lenghia902/15W_audio_power_amplifier/docs/PBL2_report_vi.pdf

TRƯỜNG ĐẠI HỌC BÁCH KHOA – ĐẠI HỌC ĐÀ NẴNG

KHOA ĐIỆN TỬ - VIỄN THÔNG

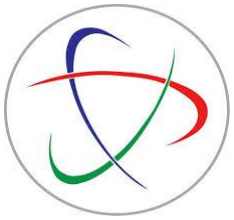
[picture p11: figure]

# PBL 2: THIẾT KẾ MẠCH ĐIỆN TỬ

## Đề tài: Mạch khuếch đại công suất OCL đơn

Giảng viên hướng dẫn:

TS. Huỳnh Thanh Tùng

Th.S Vũ Vân Thanh

Sinh viên thực hiện: Lê Khắc Nghĩa

Nguyễn Trần Tâm Nguyên

Phạm Thị Trà Giang

Đà Nẵng, ngày 28 tháng 11 năm 2025

1

MỤC LỤC

2

3

4

PHIẾU ĐÁNH GIÁ QUÁ TRÌNH THỰC HIỆN MÔN HỌC

Tên đồ án: Thiết Kế Mạch OCL Ngõ Vào Đơn

Nhóm HP: 23.Nh41A

Giảng viên hướng dẫn lý thuyết: T.S Huỳnh Thanh Tùng

Giảng viên hướng dẫn thực hành: Thầy Vũ Vân Thanh

### 1. Yêu cầu thiết kế của đề tài

-Công suất 15W | -Trở kháng loa 4Ω
-Kiểu ngõ vào đơn | -Méo phi tuyến 0,2%
-Kiểu mạch OCL | -Băng thông 50-15kHz
-Trở kháng vào Zin= 200KΩ | -Điện áp vào Vin = 0,7V

### 2. Mức độ đóng góp

STT | Họ và tên sinh viên | Mức độ đóng góp | Ghi chú
1 | Lê Khắc Nghĩa | 34%
2 | Nguyễn Trần Tâm Nguyên | 33%
3 | Phạm Thị Trà Giang | 33%

5

LỜI MỞ ĐẦU

Ngành Điện tử là một trong những ngành quan trọng góp phần vào sự phát triển của đất nước, sự phát triển nhanh chóng của Khoa học – Công nghệ làm cho ngành điện tử ngày càng phát triển và đạt được nhiều thành tựu mới

Có thể nói, mạch khuếch đại âm thanh là một trong những sản phẩm tạo nền tảng phát triển cho những sản phẩm điện tử phát triển phục vụ chon hu cầu sống của con người

Sau thời gian học tập vừa qua, với lượng kiến thức đã được tích lũy đã đảm bảo cho chúng em có thể thiết kế và thực hành được mạch khuếch đại loa. Nhờ sự hướng dẫn tận tình của thầy Huỳnh Thanh Tùng, thầy Vũ Vân Thanh cùng các anh chị đi trước chúng em đã hoàn thiện đồ án một cách tốt nhất có thể. Mặc dù vậy vẫn không thể tránh khỏi được những sai sót trong quá trình thiết kế và thi công mạch. Vì vậy nhó em rất mong nhận được những lời góp ý, giúp đỡ của thây cô để rút kinh nghiệm ở những đồ án trong tương lai

6

PHẦN 1: CƠ SỞ LÝ THUYẾT

CHƯƠNG 1: KHUẾCH ĐẠI TÍN HIỆU NHỎ

### 1.1 Khuếch đại âm tần là gì?

- Định nghĩa: Mạch khuếch đại âm tần là các mạch hoạt động với các tín hiệu hình sin và không sin, có dải tần nằm trong khoảng tai người có thể nghe được. Thông thường, tai của một người có sức khoẻ tốt có thể nghe được các âm thanh từ 20Hz đến 20KHz.
- Ta sử dụng mạch khuếch đại âm tần vì nhiệm vụ của nó là khuếch đại điện áp và công suất các dạng tín hiệu xoay chiều trong dải tần số âm thanh. Mạch khuếch đại âm tần khuếch đại các tín hiệu có tần số 20Hz đến 20KHz là dải tần số nghe được của âm thanh nên mạch khuếch đại âm tần được lựa chọn để khuếch đại các tín hiệu âm thanh.
- Mạch khuếch đại công suất âm tần dùng để tạo ra một lượng công suất để cung cấp cho tải (tải thường là loa do chúng đòi hỏi một lượng công suất lớn để biến đổi tín hiệu điện thành sóng âm). Mạch khuếch đại công suất âm tần thường được sử dụng trong các máy: radio, máy thu hình, máy nghe băng, máy tăng âm, các hệ thống stereo, loa phát thanh,…

### 1.2 Mạch phân cực

1.2.1 Mạch phân cực cố định

Sơ đồ mạch

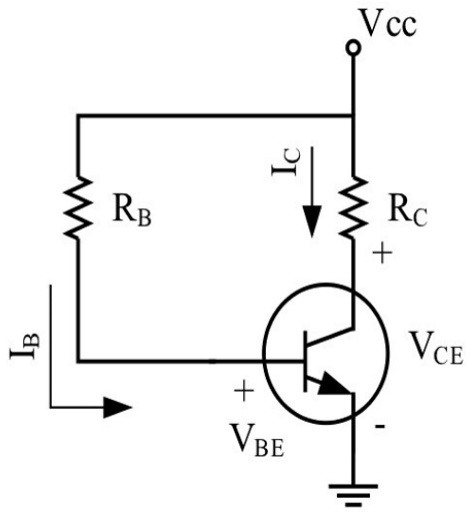
[picture p12: figure]

7

- Giả sử BJT hoạt động ở vùng tích cực (khuếch đại)
- Áp dụng KVL đối với mạch ngõ vào: VCC − IBRB − VBE = 0
- IB =

VCC−VBE
RB

Với Vbe = 0,7V nếu là loại Silic, Vbe = 0,3V nếu là loại Ge.

- Do đó, dòng IB phụ thuộc vào giá trị điện áp điện trở RB
- Trong vùng khuếch đại Ic = β.Ib
- Phương trình đường tải tĩnh Vce = Vcc – Ic.Rc
- Ưu điểm: Dòng ra lớn, dễ thiết kế.
- Nhược điểm: Khi nhiệt độ thay đổi, các đại lượng như β, Vceo, Ib thay đổi dẫn đến điểm làm việc bị sai lệch.
- Ứng dụng: Sử dụng ở các tầng công suất lớn.

1.2.2 Mạch phân cực bằng cầu phân áp

Sơ đồ mạch

- Vbb=Vcc .

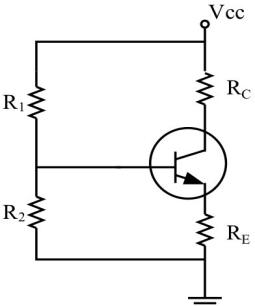
[picture p13: figure]

R2
R1+R2
- Rbb = R1//R2
- Ib=

VBB−Vbe
RBB+(β+1)RE
- Ic = β. Ib ở vùng khuếch đại
- Vce = Vcc – (Rc + Re).Ic
- Icsat =

Vcc
Rc+Re
- Ưu điểm: Việc xác định điểm làm việc tĩnh Q ít phụ thuộc vào hệ số β.
- Nhược điểm: Thiết kế và tính toán phức tạp.
- Ứng dụng: Sử dụng phổ biến trong các mạch khuếch đại, các mạch công suất lớn, BJT hoạt động ở nhiệt độ cao.

8

1.2.3 Mạch phân cực hồi tiếp Emitter

- IB =

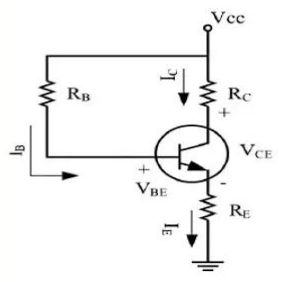
[picture p14: figure]

VCC−VBE
RB+(β+1)RE
- Trong vùng khuếch đại IC = β.IB
- Phương trình đường tải tĩnh VCE = VCC − (RC + RE) . IC
- Icsat =

VCC
RC+RE
- Ưu điểm: Có trở hồi tiếp cực E, tăng độ ổn định của điểm làm việc tĩnh.
- Nhược điểm: Việc xác định điểm làm việc vẫn còn phụ thuộc nhiều vào β.
- Ứng dụng: Sử dụng ở các tầng công suất.

1.2.4 Mạch phân cực hồi tiếp Collector

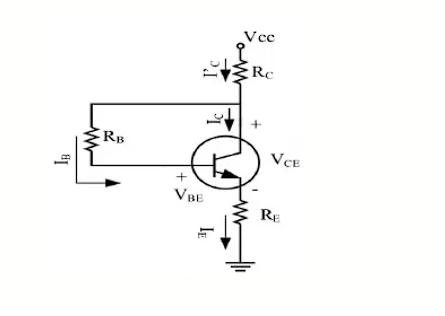
[picture p15: figure]

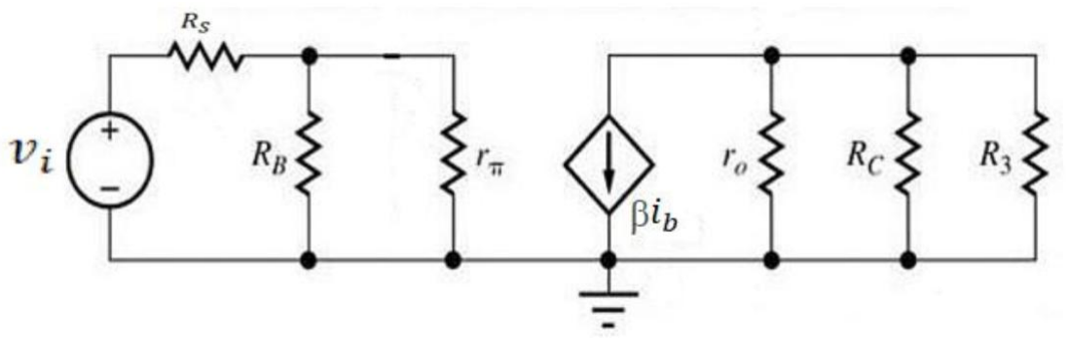
[picture p16: figure]

9

- IB =

VCC−VBE
RB+β(RC+RE)
- IC = β . IB trong vùng khuếch đại
- VCE = VCC − (RC + RE

). IC
- Ưu điểm: Khả năng hồi tiếp tốt hơn hồi tiếp cực Emitter, cải thiện độ ổn định của BJT.
- Nhược điểm: Khó thiết kế và tính toán.

### 1.3 Cách mắc BJT

1.3.1 Mạch khuếch đại mắc E chung

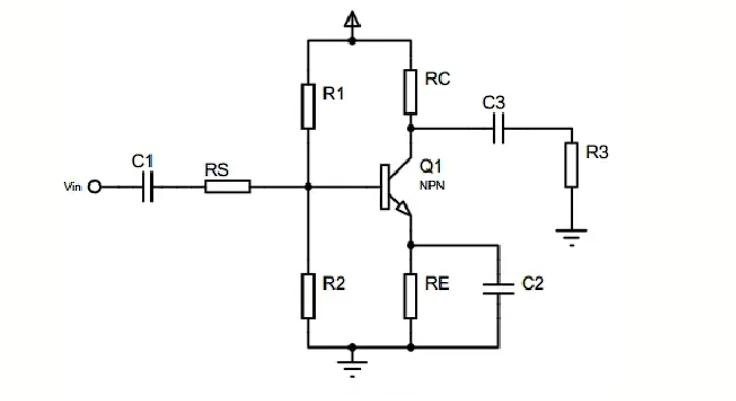
[picture p17: figure]

Sơ đồ tương đương hai chiều

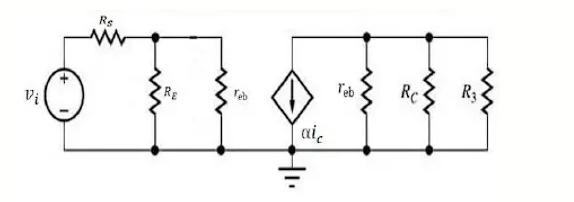
[picture p18: figure]

10

- Hệ số khuếch đại điện áp: Av = −gm. RL

Rin

RI+Rin

với Rin = R1//R2 // rπ

- Hệ số khuếch đại dòng: Ai = Av .

RI+Rin
R3
- Hệ số khuếch đại công suất: Ap = Av
. Ai
- Rout = r0 // RC
- Điều kiện của vi để mạch hoạt động tuyến tính: vi ≤ 0.005.

RI+Rin

Rin
- Tín hiệu vào và ra ngược pha nhau.
- Ưu điểm: Khuếch đại đồng thời cả áp và dòng.
- Nhược điểm: Hệ số khuếch đại ở mức trung bình.
- Ứng dụng: Sử dụng ở các tầng đầu vào và tầng thúc của mạch khuếch đại công suất

1.3.2 Mạch khuếch đại mắc B chung

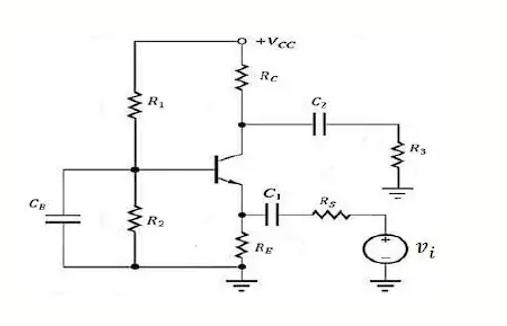
[picture p19: figure]

Sơ đồ tương đương xoay chiều

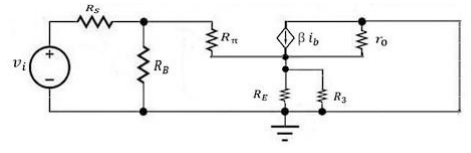
[picture p20: figure]

11

- Hệ số khuếch đại điện áp: Av =

gmRLRin
(RI+Rin)
- Rin =

1
gm

// RE

- Hệ số khuếch đại dòng: Ai = Av .

RI+Rin
R3
- Hệ số khuếch đại công suất: Ap = Av . Ai
- Rout = Ric // RC
- RiC = r0(1 + gm(RI// RE))
- Điều kiện của vi để mạch hoạt động tuyến tính: vi ≤ 0.005.

RI+Rin

Rin
- Tín hiệu vào và ra đồng pha
- Ưu điểm: Hệ số khuếch đại áp lớn, trở kháng vào mạch lớn
- Nhược điểm: Không khuếch đại dòng
- Ứng dụng: Sử dụng trong các mạch yêu cầu áp ra cao

1.3.3 Mạch khuếch đại mắc C chung

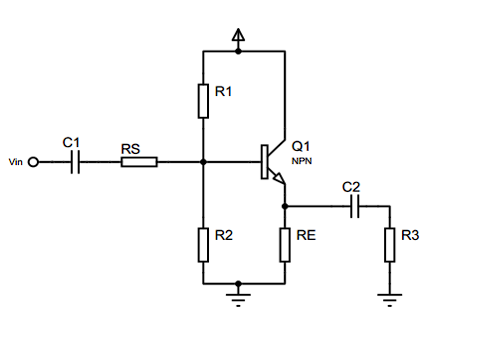
[picture p21: figure]

Sơ đồ tương đương xoay chiều

12

- Hệ số khuếch đại điện áp: Av =

gmRLRin
(RI+Rin)(1+gmRL)
- Rin = rπ(1 + gmRL)//RB
- Hệ số khuếch đại dòng: Ai = Av .

RI+ Rin
R3
- Hệ số khuếch đại công suất: Ap = Av . Ai
- Rout = (

1
gm

+

RI / / RB
β+1

) // R3

- Điều kiện của vi để mạch hoạt động tuyến tính: vi ≤ 0.005.

RI+Rin

Rin

(1 +

gmRL)
- Tín hiệu vào và ra đồng pha
- Ưu điểm: Hệ số khuếch đại áp lớn, trở kháng vào mạch lớn
- Nhược điểm: Hệ số khuếch đại áp xấp xỉ bằng 1
- Ứng dụng: Sử dụng trong các tầng yêu cầu dòng ra cao, tầng công suất

### 1.4 Kết luận

- Tầng khuếch đại tín hiệu nhỏ giúp khuếch đại dòng điện và điện áp tạo tiền đề để chuyển qua tầng thúc.
- Mạch C chung khuếch đại dòng lớn, không khuếch đại điện áp, tín hiệu vào và ra đồng pha nhau.
- Mạch E chung khuếch đại cả áp và dòng, tín hiệu vào và ra ngược pha nhau.
- Mạch B chung có hệ số khuếch đại điện áp lớn, khuếch đại dòng thấp, tín hiệu vào và ra đồng pha nhau.

KẾT LUẬN CHƯƠNG

Tầng khuếch đại tín hiệu nhỏ giúp khuếch đại dòng điện và điện áp tạo tiền đề để chuyển qua tâng thúc, nhưng vì tầng khuếch đại tín hiệu nhỏ thường không ổn định do nhiệt độ thay đổi nên ta cần hồi tiếp tín hiệu ra trở về tín hiệu vào.

13

CHƯƠNG 2: MẠCH KHUẾCH ĐẠI HỒI TIẾP

### 2.1. Giới thiệu chung

Chương 2 giới thiệu những kiến thức cơ bản về mạch khuếch đại hồi tiếp, bao gồm khái niệm, nguyên lý hoạt động và vai trò của hồi tiếp trong việc ổn định và cải thiện đặc tính của bộ khuếch đại. Nội dung chương cũng trình bày mạng 4 cực hồi tiếp và phân tích ảnh hưởng của hồi tiếp âm đến các thông số quan trọng của mạch.

### 2.2. Định nghĩa khuếch đại hồi tiếp

Mạch hồi tiếp là mạch lấy một phần năng lượng ở ngõ ra đưa về cung cấp cho ngõ vào để điều chỉnh lại các thông số và chỉ tiêu kỹ thuật của mạch khuếch đại.
Sơ đồ khối khuếch đại có hồi tiếp

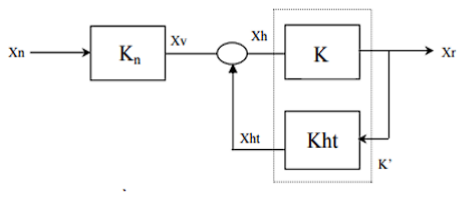
[picture p22: figure]

Hình 2.1 Khối bộ khuếch đại có hồi tiếp

K: Hệ số khuếch đại; Kℎt

: Hệ số hồi tiếp

Xv

: Tín hiệu vào; Xℎ: Tín hiệu hiệu

Xr

: Tín hiệu ra; Xℎt

: Tín hiệu hồi tiếp

- Mạch điện của bộ khuếch đại có hồi tiếp ân được phân làm 4 loại:
- Hồi tiếp nối tiếp – điện áp: Tín hiệu hồi tiếp đưa về đầu vào nối tiếp với

nguồn tín hiệu ban đầu và tỉ lệ với điện áp ở đầu ra

- Hồi tiếp song song – điện áp: Tín hiệu hồi tiếp về đầu vào song song với

nguồn tín hiệu ban đầu và tỉ lệ với điện áp đầu ra

- Hồi tiếp nối tiếp – dòng điện: Tín hiệu hồi tiếp về đầu vào nối tiếp với nguồn

tín hiệu ban đầu và tỉ lệ dòng điện ra

- Hồi tiếp song song – dòng điện: Tín hiệu hồi tiếp về đầu vào song song với

nguồn tín hiệu ban đầu và tỉ lệ với dòng điện ra

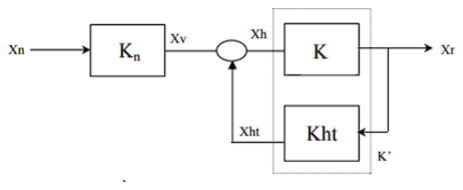
[picture p23: figure]

14

### 2.3. Hồi tiếp âm

2.3.1. Các phương trình cơ bản của mạng 4 cực hồi tiếp âm

Hình 2.2 Sơ đồ mạng 4 cực hồi tiếp

Xv
: Tín hiệu vào của toàn mạch

Kn: Hàm truyền của mạch vào

Xr
: Tín hiệu ra của mạch

K: Hàm truyền đạt của mạch khi khong có hồi tiếp

Xℎ = Xv − Xℎt = Xv − Kℎt

.Xr = Xr − Kℎt

. Xℎ.K → Xℎ =

Xv
1 + K.Kℎt

Với Kℎt

: Hàm truyền đạt của mạch hồi tiếp

-Hệ số khuếch đại khi có hồi tiếp âm

K

′ =

Xr
Xv

=

Xr
(1 + K.Kℎt)Xℎ

=

K. Xn
(1 + K.Kℎt)Xℎ

=

K
1 + K.Kℎt

Nếu không có hồi tiếp âm (Kℎt= 0) → K

′= K

Nếu có hồi tiếp âm (Kℎt ≠ 0) → K

′ < K

15

-Hệ số khuếch đại toàn mạch của mạch điện

Ktp = Kn.K

′ = Kn.

K
1 + K.Kℎt

-Hệ số khuếch đại vòng: Kv = K.Kℎt

-Độ sau hồi tiếp: g = 1 + K.Kℎt = 1 + Kv

→ K

′ =

K
g

; Ktp =

Kn.K
g

g > 1 → K

′ < K: có hồi tiếp âm

g < 1 → K

′ > K: có hồi tiếp dương

2.3.2. Ảnh hưởng của hồi tiếp âm đến các tính chất của bộ khuếch đại]
- Khi có hồi tiếp âm K

′ < K nên hệ số khuếch đại giảm

- Ảnh hưởng đến trở kháng vào

+ Sự thay đổi trở kháng vào chỉ phụ thuộc vào cách mắc mạch hồi tiếp về đầu vào

mà không phụ thuộc cách lấy tín hiệu ở đầu ra

+ Trở kháng vào của bộ khuếch đại có hồi tiếp âm nối tiếp tăng g lần so với mạch

không có hồi tiếp

-Ảnh hưởng đến độ ổn định của hệ số khuếch đại

Ktp = Kn.

K
1 + K.Kℎt

Giả sử vì một lý do nào đó, hệ số khuếch đại ∆K, lập tức theo vòng hồi tiếp âm sẽ

có 1 phần tín hiệu đưa ngược trở lại đầu vào và ngược pha tín hiệu vào, kéo hệ số

khuếch đại trở về giá trị ban đầu

Ảnh hưởng đến nhiễu và tạp âm

16

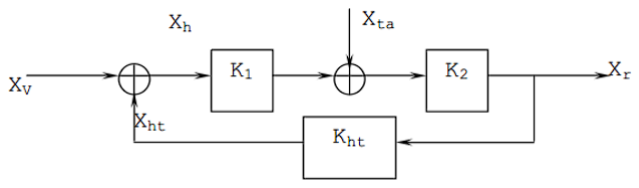
[picture p24: figure]

Hình 2.3 Ảnh hưởng của hồi tiếp âm đến nhiễu và tạp âm

Xta: Xuất hiện ở cửa ra tầng khuếch đại 1, mắc thêm K2 vào vòng hồi tiếp âm Ta có: [(Xv − Xℎt).K1 + Xta ].K2 = Xr ↔ K1K2
.Xv − K1K2

. Xℎt + K2

.Xta =

Xr

Thay Xℎt = Kℎt

. Xr

→ Xr =

K1.K2
1 + K1.K2.Kℎt

. Xv +

K2
1 + K1.K2.Kℎt

. Xta

Xr =

Xv

Kℎt

+

Xta
K1Ktℎ

Như vậy tín hiệu giảm Kℎt lần, nhiễu giảm K1.Kℎt
lần

-Ảnh hưởng của hồi tiếp âm đến dải thông của bộ khuếch đại và méo phi tuyến

+ Khi có hồi tiếp, toàn bộ tín hiệu đưa đến đầu vào của bộ khuếch đại và méo phi tuyến Xℎ = Xr

+ Khi có hồi tiếp, chỉ 1 phần tín hiệu đặt vào bộ khuếch đại

Xℎ= Xv

- Xℎt= Xv – K. KℎtXℎ

Xℎ=

Xv
g
Do đó dải thông của bộ khuếch đại được mở rộng

Ngoài ra, do tín hiệu vào của bộ khuếch đại có hồi tiếp Xℎ nhỏ hơn khi không có hồi tiếp g lần nên méo phi tuyến cũng giảm

17

KẾT LUẬN CHƯƠNG

Mạch khuếch đại hồi tiếp giúp cải thiện các tính chất của bộ khuếch đại, nâng cao chất lượng của bộ khuếch đại, kết hợp với tầng thúc để đưa tín hiệu sang tầng khuếch đại công suất để đảm bảo tín hiệu ít bị méo phi tuyến hơn và cho ra chất lượng âm thanh tốt hơn

18

CHƯƠNG 3: CÁC CHẾ ĐỘ KHUẾCH ĐẠI CÔNG SUẤT

### 3.1 Giới thiệu chung

- Khuếch đại công suất là tầng cuối của thiết bị khuếch đại. Nó có nhiệm vụ cung cấp cho ta một tín hiệu trung thực đạt công suất mong muốn và có hiệu suất hợp lý.

### 3.2 Các tham số của tầng khuếch đại công suất

- Hệ số khuếch đại công suất Kp =

Pr
Pv
- Hiệu suất ŋ =

Pr
Po

với Po là công suất cung cấp 1 chiều

### 3.3 Chế độ làm việc và điểm làm việc cho tầng khuếch đại công suất

- Tùy thuộc vào chế độ làm việc của transistor mà bộ khuếch đại công suất làm việc ở chế độ A, B, AB
- Khuếch đại công suất loại A: Tín hiệu được khuếch đại gần như tuyến tính, nghĩa là tín hiệu ngõ ra thay đổi tuyến tính trong toàn bộ chu kỳ 360° của tín hiệu ngõ vào (Transistor hoạt động cả hai bán kỳ của tín hiệu ngõ vào)
- Khuếch đại công suất loại AB: Transistor được phân cực ở gần vùng ngưng. Tín hiệu ngõ ra thay đổi hơn một nửa chu kỳ của tín hiệu vào (Transistor hoạt động hơn một nửa chu kỳ - dương hoặc âm – của tín hiệu ngõ vào)
- Khuếch đại công suất loại B: Transistor được phân cực tại Vbe = 0 (vùng ngưng). Chỉ một nửa chu kỳ âm hoặc dương – của tín hiệu ngõ vào được khuếch đại

19

3.3.1 Chế độ A

Đặc tuyến

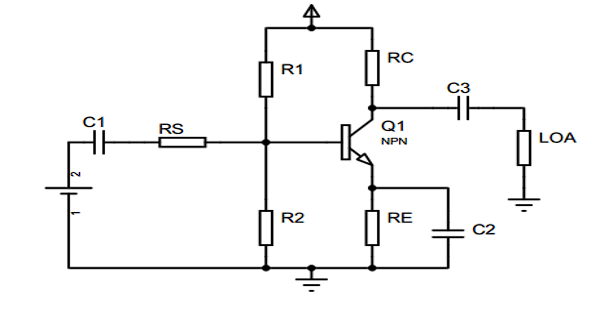
[picture p25: figure]
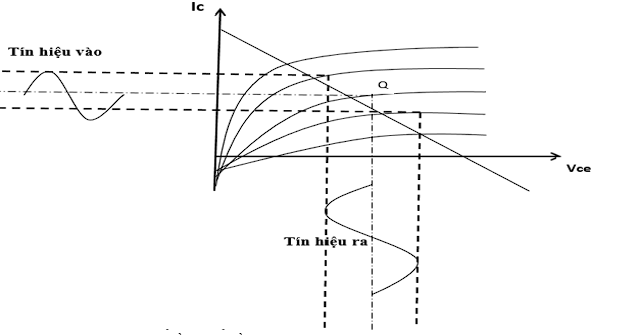
[picture p26: figure]

- Dòng điện và điện áp đầu vào tồn tại 360° trong 1 chu kỳ của tín hiệu vào
- Hiệu suất ŋ =

PL

PCC

=

VDD

ILP
2
2VDDILP

=

1
4

= 25%

- Ưu điểm: Tín hiệu ra không bị méo dạng
- Nhược điểm:
- Hiệu suất thấp ~ 25%
- Tiêu hao (nhiệt) lớn
- Ứng dụng: Sử dụng ở các tầng không yêu cầu hiệu suất cao nhưng phải đảm bảo tín hiệu như tầng đầu vào và tầng thúc của mạch khuếch đại

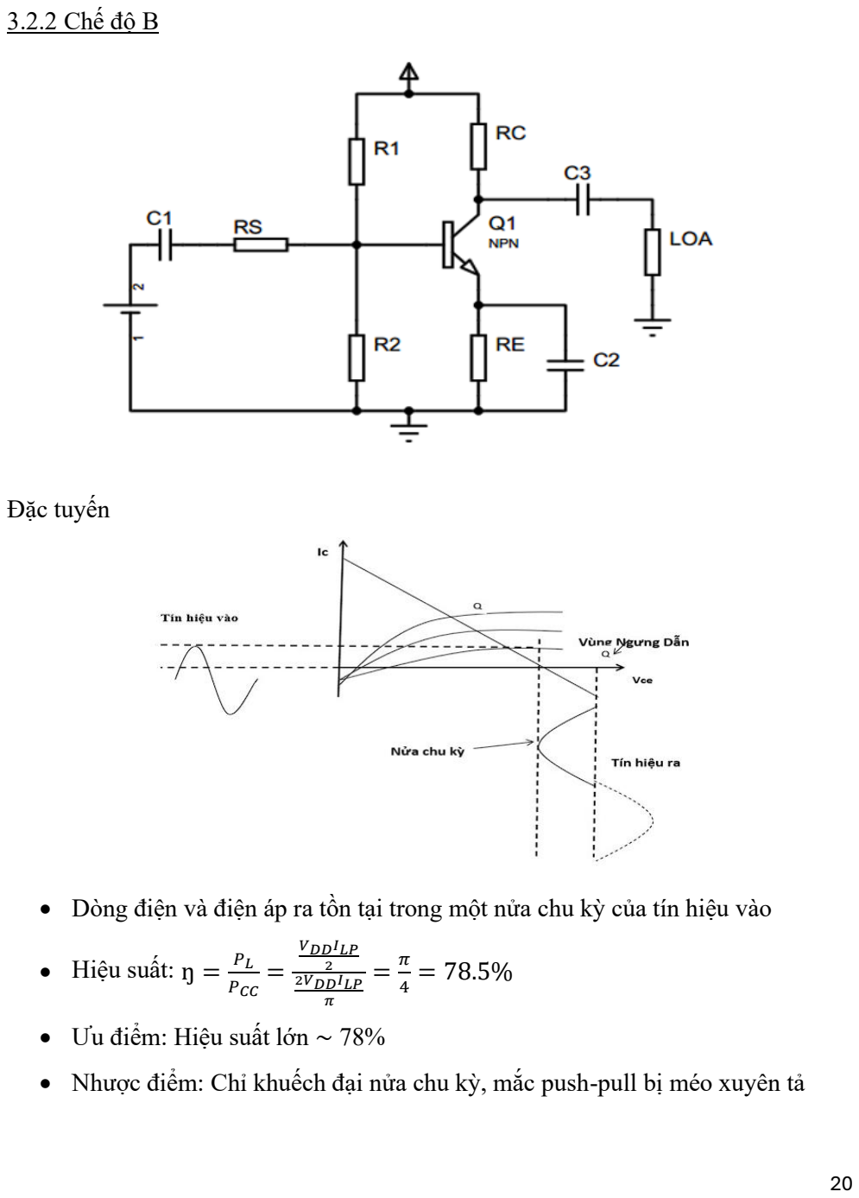
[picture p27: page 21]

20

3.2.2 Chế độ B

Đặc tuyến

- Dòng điện và điện áp ra tồn tại trong một nửa chu kỳ của tín hiệu vào
- Hiệu suất: ŋ =

PL

PCC

=

VDDILP
2
2VDDILP
π

=

π
4

= 78.5%

- Ưu điểm: Hiệu suất lớn ~ 78%
- Nhược điểm: Chỉ khuếch đại nửa chu kỳ, mắc push-pull bị méo xuyên tả

21

3.3.3 Chế độ AB

Ta có thể sửa lại vấn đề méo trong mạch loại B nhưng vẫn cải thiện hiệu suất bằng cách kết hợp 2 loại A và B

Đặc tuyến

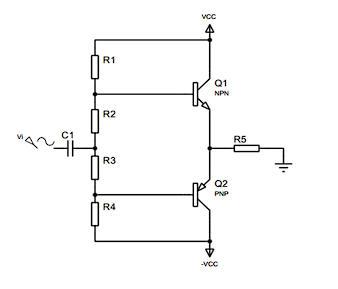
[picture p28: figure]
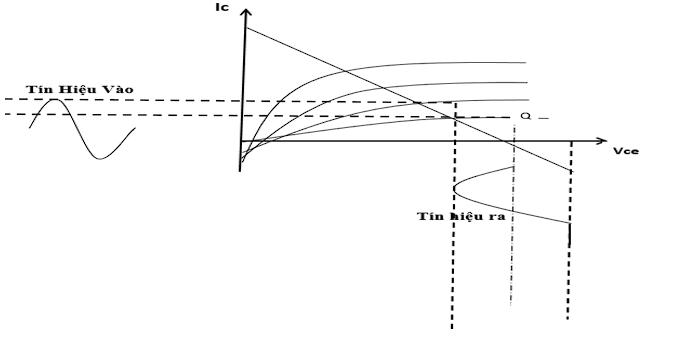
[picture p29: figure]

- Ưu điểm: Hiệu suất cao, bảo toàn tín hiệu
- Nhược điểm: Các tầng khuếch đại công suất được thiết kế làm việc ở chế độ AB, điểm làm việc của chế độ AB nằm giữa chế độ A và chế độ B

22

### 3.4 Mạch khuếch đại công suất OCL

3.4.1 Giới thiệu mạch OCL

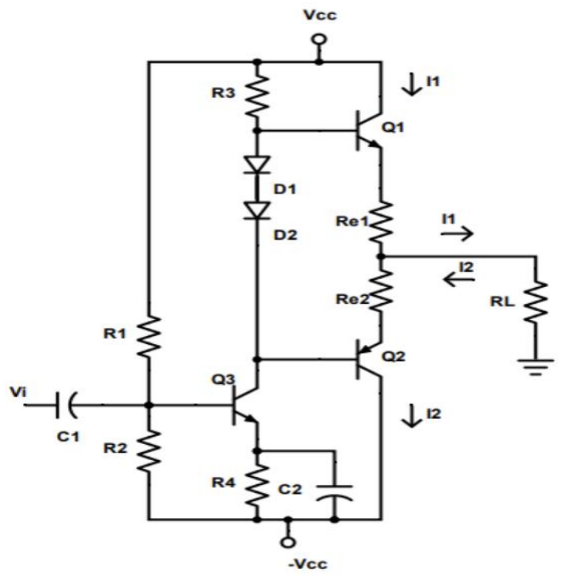
[picture p30: figure]

- Sử dụng 2 nguồn đối xứng (+/- VCC)
- Ở bán kì dương của Vi: Vb/Q3 tăng → Q3 dẫn → Vce/Q3 giảm → Vc/Q3 giảm

→ Q1 tắt, Q2 dẫn → Tín hiệu I2 chạy từ Mass → RL → Re2 → Q2 → - VCC

- Ở bán kì âm của Vi: Vb/Q3 giảm → Q3 tắt → Vce/Q3 tăng → Vc/Q3 tăng

→ Q1 dẫn, Q2 tắt → Tín hiệu I1 chạy từ VCC → Q1 → Re1 → RL → Mass

3.4.2 Ưu điểm và nhược điểm của mạch

- Ưu điểm:
- Mạch không có tụ ở đầu ra nên bang thông của mạch được mở rộng, không gây méo ở tần số thấp
- Hiệu suất cao
- Tín hiệu không bị méo xuyên tâm
- Nhược điểm:
- Mạch khó thiết kế, sử dụng nguồn đôi
- Không có tụ đầu ra, tín hiệu DC dễ đi qua loa, gây cháy loa
- Do tải ghép trực tiếp nên phải có mạch bảo vệ quá công suất

23

### 3.5 Mạch khuếch đại công suất OTL

3.5.1. Giới thiệu mạch OTL

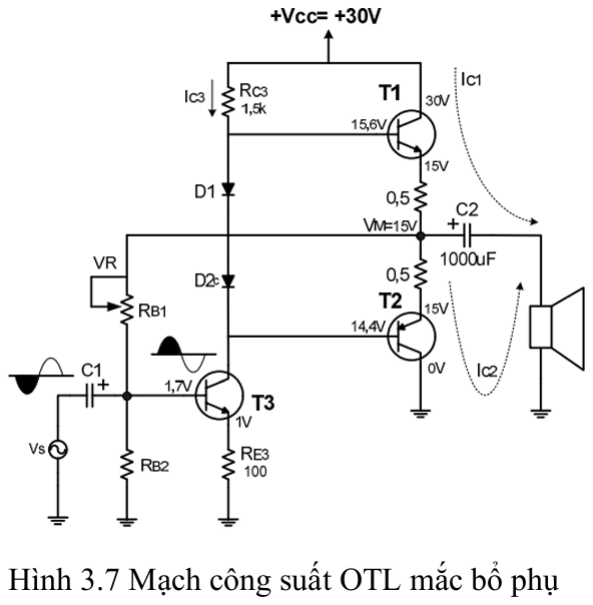
[picture p31: figure]

Mạch OTL (Output Transfomer Less) là mạch khuếch đại công suất không cần sử dụng biến áp đầu ra, được sử dụng trong các bộ khuếch đại âm thanh chất lượng cao.

Nhận xét mạch OTL:
- T1, T2 là 2 transistors có cùng thông số như công suất, hệ số khuếch đại β, được chế tạo cùng chất (thường là Si)
- T1 và T2 có cùng các thông số kỹ thuật nên trong mạch điện phải có cùng điều kiện làm việc, điện áp điểm giữa VM = 1/2 VCC
- Hai diode D1, D2 dùng để phân cực điện áp cho cực BT1 – BT2
- Mạch OTL mắc bổ phụ thường sử dụng hai BJT: một NPN và một PNP, để khuếch đại tín hiệu theo push-pull

Đặc điểm chung mạch OTL

- Sử dụng nguồn đơn, có tụ xuất âm nối với tải RL ở ngõ ra
- Tụ xuất âm ngăn dòng 1 chiều nhỏ cho thành phần xoay chiều đi qua, bảo vệ loa
- Mạch mắc kiểu bổ phụ, các transistor luân phiên dẫn mỗi con một bán kỳ của tín hiệu ngõ vào nên cho ra tải đủ cả hai bán kỳ

24

3.5.2 Ưu điểm và nhược điểm của mạch OTL

- Ưu điểm:
- Giảm độ phức tạp thiết kế, tín hiệu ra ít méo và có hiệu suất cao.
- Đáp ứng nhanh, chất lượng âm thanh cao.
- Nhược điểm:
- Thường phù hợp loa có tổng trở thấp
- Khó cân chỉnh điểm giữa, có tụ xuất âm nên gây tổn hao tín hiệu ở tần số thấp

KẾT LUẬN CHƯƠNG

Ta đã tổng hợp được kiến thức về cấu tạo nguyên lý hoạt động của các linh kiện các loại mạch khuếch đại công suất. Các định lý và công thức quan trọng đã tìm hiểu sẽ tạo cơ sở để tiến tới các bước tính toán trong chương tiếp theo

25

CHƯƠNG 4: CÁC MẠCH PHỤ TRỢ

### 4.1 Giới thiệu chung

Trong thực tế, để nâng cao hiệu suất cũng như chất lượng của mạch khuếch đại công suất, cần dung thêm các mạch bổ trợ

### 4.2 Mạch khuếch đại Darlington

Trong trường hợp các mạch khuếch đại yêu cầu có hệ số khuếch đại dòng điện lớn hay tăng trở kháng vào có thể tổ hợp một số transistor thành sơ đồ Darlington để đạt được yêu cầu trên

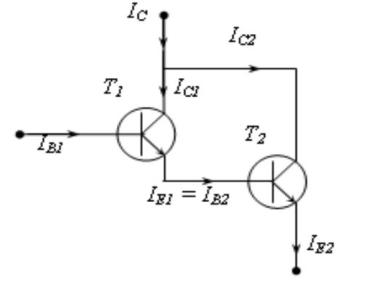
[picture p32: figure]

- Ta có: IE1 = IE2
- Ở chế độ tĩnh: IE1 = (1+ β1) IB1

→ IE2 = (1+ β2) IB2 = (1+ β2) IE1 = (1+ β2) (1+ β1) IB1

→ IE2 = β1β2 IB1 = βIB1

Vậy hệ số khuếch đại dòng của mạch: β = β1β2

26

### 4.3 Nguồn dòng

Một biện pháp phổ biến đển ổn định dòng cấp cho tầng công suất là sử dụng nguồn dòng. Ngoài ra, nguồn dòng có nội trở lớn sẽ nâng cao trở kháng ra cho tầng thúc

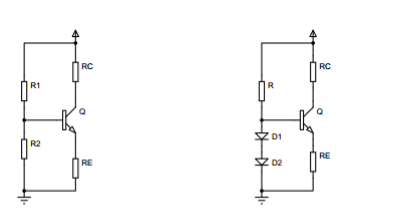
[picture p33: figure]

Hình a | Hình b
Nguồn dòng được phân cực bằng

Hình a: Điện trở; Hình b: Diode

- Việc phân cực nguồn dòng bằng điện trở có nhược điểm là không ổn định, điện áp hai đầu có thể thay đổi, nguồn cấp biến áp không ổn định → nguồn dòng không ổn định
- Để khắc phục nhược điểm trên thì phân cực bằng diode là tốt hơn, lợi dụng tính chất của sự sụt áp trên diode → tạo ra một nguồn phân cực khá ổn định

### 4.4 Mạch bù trở kháng Zobell

Mạch Zobell là mạch bù trở kháng loa ở tần số cao. Do loa có tính cảm (L) nên trở kháng loa tăng theo tần số, làm tín hiệu ra loa không ổn định, để khắc phục người ta mắc Zobell.

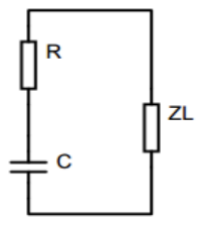
[picture p34: figure]

27

Khi tần số tăng thì ZL tăng, khi đó zC = jωC sẽ giảm, do đó Ztđ = ZL // ZC sẽ không đổi

Trở kháng loa được xác định

Ztđ = (R +

1
jωC) // (r+ jωL) =

(R +

1
jωC).(r+ jωL)

R +

1

jωC + r + jωL =

r.(1−ω²RLC
r

)+jω.(RC+

L
r

)
1 − ω²LC + jωC.(R+r)

KẾT LUẬN CHƯƠNG

Mạch khuếch đại Darling, nguồn dòng và mạch bù trở kháng Zobel đều đóng vai trò quan trọng trong việc ổn định và nâng cao các thông số của mạch.

28

PHẦN 2: THIẾT KẾ VÀ TÍNH TOÁN

Yêu cầu:

- Công suất: 15W
- Loại mạch: OCL đơn
- Trở kháng vào: 200000 Ohm
- Trở kháng loa: 4 Ohm
- Băng thông: 50 – 15000 Hz
- Méo phi tuyển 0.2%

Sơ đồ thiết kế


29

CHƯƠNG 5: TÍNH TOÁN PHẦN NGUỒN

Giả sử tín hiệu vào có dạng:

vi = VIP. sin ωt

Tín hiệu ra loa có dạng:

vL = VL

. sin ωt (V)

iL = IL

. sin ωt (A)

Với VL
là điện áp cực đại trên tải

IL
là dòng điện cực đại qua tải

Điện áp hiệu dụng và dòng hiệu dụng qua tải

Ta có: VLℎd =

VL
√2

và ILℎd =

IL
√2
Công suất trên tải:

PL = RL

.ILℎd

2 =

VLℎd

2
RL

=

VLP

2
2RL

→ VL = √2PLRL = √2.15.4 = 10,954 (V)

→ IL =

VL
RL

= 2,74 (A)

Điện áp nguồn cung cấp:

Ta có Q1,Q2 làm việc ở chế độ AB nên chọn hệ số sử dụng nguồn là ε = 0,8

→ Vcc =

VL
0,8

= 13,75 (V)

→ Ta chọn nguồn cung cấp là ±18V

30

Dòng cung cấp trung bình:

ICCtb =

2IL
π
→ Pcc = ICCtb. Vcc = 31,4 (W)

PL =

1
2

. RL

.IL

2 = 15 (W)

Hiệu suất mạch:

ŋ =

PL

Pcc

. 100% =

15
31,4

. 100% = 47,77 %

31

CHƯƠNG 6: TÍNH TOÁN TẦNG CÔNG SUẤT

### 6.1 Tính chọn trở R1, R2

Vì mạch làm việc ở chế độ AB nên dòng tĩnh collector nằm trong khoảng 20 ÷ 50mA. Ở đây ta chọn: IE/Q1 = IE/Q2 = 50 (mA)

Dòng cực đại qua Q1, Q2 là:
IE/Q1 = IE/Q2 = IE/Q1 + IL = 0,05 + 2,74 = 2,79 (A)

R1, R2 là hai điện trở ổn định nhiệt, tạo dòng hồi tiếp để cân bằng tầng đẩy kéo, dòng qua tải cũng chính là dòng qua trở, để không ảnh hưởng đến công suất của tải nên phải có công suất lớn.

Để công suất ra loa đạt cực đại thì sụt áp trên 2 điện trở này không quá lớn, tránh hao phí ta chọn:

VR1
VL

≥

1
20 → VR1 ≥

VL
20

=

10,954
20

= 0,55 (V)

→ R1 = R2 =

VR1

IE/Q1

= 0,197 (Ω)

Công suất trở R1, R2:

PR1 = PR2 =

1
2

R1.IL

2 = 0,37 (W)

→ Ta chọn trở R1, R2 là 0, 22Ω/2W

### 6.2 Tính chọn cặp Q1, Q2

Công suất nguồn cung cấp:

PCC = VCC.ICCtb = VCC.

2IL
π

Công suất loa: PL = RL

.ILℎd

2 =

1
2

RL

IL

2

32

Công suất tiêu tán của R1, R2:

PR = 2PR1 =

1
2

RL

IL

2

Vậy công suất tiêu tán của 2 BJT Q1, Q2:

2Ptt = PCC − PL − 2PR =

2VCCIL
π

−

1
2

RL

IL

2 − 2.

1
2

R1IL

2

Công suất tiêu tán của 1 BJT là:

Ptt/Q1 = Ptt/Q2 =

VCCIL
π

−

1
4

(RL + 2R1).IL

2
(1)

Công suất tiêu tán cực đại của BJT là lấy đạo hàm theo IL cho bằng 0:

dPtt/Q1
dIL

=

VCC
π

−

1
2

(RL + 2R1).IL = 0

→ IL =

2VCC
π(RL+2R1)

(2)

Thay (2) vào (1), ta được:

Pttmax/Q1 =

2VCC

2
π

2(RL + 2R1)

−

1
4

4VCC

2
π

2(RL + 2R1)
2

. (RL + 2R1) = 7,78 (W)

Công suất tiêu tán tĩnh trên Q1:

PttDC/Q1 = VCE/Q1.IC/Q1 ≈ VCC.IEQ = 0,9 (W)

Vậy công suất tiêu tán cực đại trên Q1 là:

Ptt∑ max/QB1 = Pttmax/Q1 + PttDC/Q1 = 7,78 + 0,9 = 8,68 (W)

Vì Q1, Q2 là cặp BJT bổ phụ nên ta chọn Q1, Q2 thỏa mãn điều kiện:

- IC ≥ (1,5 ÷ 2)IE/Q1 = (4,2 ÷ 5,58) (A)
- VCE0 ≥ (1,5 ÷ 2)VCC = (27 ÷ 36) (V)
- PC ≫ (1,5 ÷ 2)Ptt ∑ max = (13,02 ÷ 17,36) (W)

33

→ Tra cứu Datasheet ta chọn Q1 là và Q2 là: 2SD718 và 2SB688
Loại BJT | VCE0(V) | PC(W) | IC(A) | hfe | f (MHz) | Loại
2SD718 | 120 | 80 | 8 | 55:160 | 12 | NPN
2SB688 | 120 | 80 | 8 | 55:160 | 12 | PNP

### 6.3 Tính chọn R3, R4

Ta chọn:
βQ1 = βQ2 = 55

Dòng Base tĩnh của Q1:

IBQ/Q1 =

IEQ/Q1
1 + βQ1

=

0,05
1 + 55 = 0,89 (mA)

Dòng Base cực đại của Q1:

IBP/Q1 =

IEp/Q1
1 + βQ1

=

2,79
1 + 55 = 50 (mA)

Để R3, R4 không ảnh hưởng đến dòng ra ở chế độ xoay chiều thì R3, R4 phải thỏa mãn điều

kiện: Zac/Q1 ≪ R3, R4 ≪ Zdc.Q1

- R3,R4 ≪ Zdc.Q1để rẽ dòng nhiệt
- R3,R4 ≪ Zac.Q1 để giảm tổn thất tín hiệu

Với Zdc.Q1, Zac/Q1là điện trở xoay chiều và một chiều từ cực Base Q1

Từ đặc tuyến của IC, VBE của, ta có:

IEQ/Q1 = 0,05(A) → VBEQ = 0,6 (V)

IEP/Q = 2,79 (A) → VBEmax = 0,83 (V)

Vậy

Zdc/Q1 =

VBQ/Q1

IBQ/Q1

=

VBEQ/Q1 + VR1

IBQ/Q1

= 686 (Ω)

34

Zac/Q1 =

(VBEmax/Q1 + VR1max ) − (VBEQ/Q1 + VR1)

IBQ/Q1 − IBQ/Q1

= 16,96 (Ω)

Vậy: 16,96 Ω ≪ R3, R4 ≪ 686 Ω

→ Chọn R3, R4 = 220Ω/2W

### 6.4 Tính chọn cặp Q3 Q4

Dòng tĩnh qua R3 IR3Q =

VBEQ/Q1+ VR1
R3

=

0,6+0,05.0,22
220

= 2,78 (mA)

Dòng cực đại qua R3 IR3 =

VBE/Q1+ VR1max
R3

=

0,83+2,79.0,22
220

= 6,48 (mA)

Dòng emitter tĩnh qua Q3 IEQ/Q3 = IR3Q + IBQ/Q1 = 2,78 + 0,89 = 3,67 (mA)

Dòng cực đại qua Q3 IE/Q3 = IR3 + IB/Q1 = 50 + 6,56 = 56,56 (mA)

Khi đó trở kháng xoay chiều từ cực B của Q1

Zac/Q1

′ =

VBEmax − VBQ/Q1

IE/Q3 − IEQ/Q3

=

0,83 + 0,22.2,79 − 0,6 + 0,05.0,22
(56,56 − 3,67).0,001 | = 15,75 (Ω)

So sánh với Zac/Q1 tính ở trước là ta thấy khi thêm R3, R4 vào thì sai khác không đáng kể

Như vậy, trở kháng xoay chiều Q3 là

Zac/Q3 = Zac/Q1

′ + (1 + βmin). RL = 15,75 + (1 + 55).4 = 239,75 (Ω)

Để tìm được Q3, Q4 ta tìm công suất tiêu tán lớn nhất của chúng. Gọi là biên độ dòng AC chạy qua Q3, ta có

Dòng cung cấp xoay chiều trung bình cho Q3

Itb/Q3 =

IE1
π

Công suất nguồn cung cấp cho Q3

PCC/Q3 = 2VCC.Itb/Q3 =

2VCC.IE1
π

35

Công suất cung cấp cho tải của Q3

Pt/Q3 = Zac/Q3.IE1

2 = Zac/Q3

1
2π

∫ (IE1. sinωt)
2
dωt =

π

0

1
4

IE1

2
. Zac/Q3

Công suất tiêu tán xoay chiều trên Q3

Ptt/Q3 = PCC/Q3 − Pt/Q3 =

2VCCIE1
π

−

1
4

IE1

2 Zac/Q3

Lấy đạo hàm theo và cho ta được:

IE1 =

4VCC

π. Zt/Q3

=

4.18
π. 239,75 = 0,096 (A)

Vậy công suất tiêu tán lớn nhất do dòng xoay chiều rơi trên Q3

Pttmaxac/Q1 =

2VCC.IE10
π

−

1
4

IE1

2
. Zac/Q3 = 0,548 (W)

Công suất tiêu tán tĩnh trên Q3

Pdc/Q3 = VCC.IEQ/Q3 = 18.3,67.0,001 = 0,066 (W)

Vậy tổng công suất tiêu tán cực đại trên Q3

∑Pttmax/Q3 = Pdc/Q3 + Pttmaxac/Q3 = 0,066 + 0,548 = 0,614 (W)

Vậy chọn Q3, Q4 là cặp bổ phụ thỏa mãn điều kiện sau

- IC ≥ (1,5 ÷ 2)IC/Q3 = (84,8 ÷ 113,12) (mA)
- VCE0 ≥ (1,5 ÷ 2)VCC = (27 ÷ 36) (V)
- PC ≥ (1,5 ÷ 2) ∑ Pttmax/Q3 = (0,92 ÷ 1,23) (W)

Tra cứu Datasheet ta chọn Q3 là và Q4 là TIP41C và TIP42C
Loại BJT | VCE0(V) | PC(W) | IC(A) | hfe | f (MHz)
TIP41C | 100 | 65 | 6 | 30:75 | 3
TIP42C | 100 | 65 | 6 | 30:75 | 3

36

CHƯƠNG 7: TÍNH TOÁN TẦNG THÚC

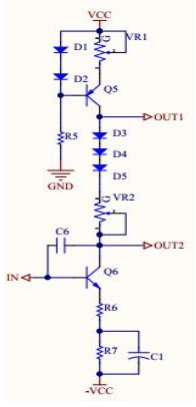
[picture p35: figure]

Để tính toán tầng thúc ta chọn: βQ3 = 75

→ IB/Q3 =

IE/Q3
1+βQ3

= 0,74 (mA)

→ IBQ/Q3 =

IE/Q3
1+βQ3

= 0,048 (mA)

### 7.1 Tính chọn D1, D2 và R5

Chọn D1, D2 là diode 1N4007

Diode | VDmax (V) | VFmax (V) | IDmax (A) | PD (W)
1N4007 | 1000 | 1,1 | 1 | 3

Dòng qua hai diode là dòng phân áp cho Q5 transistor nguồn dòng

Chọn sụt áp trên diode là VD = 0,7V

37

Theo đặc tuyến

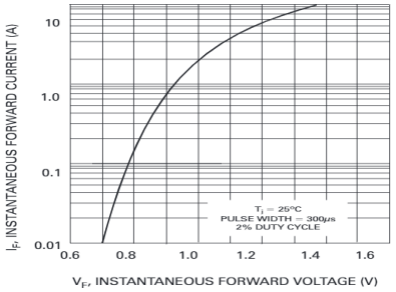
[picture p36: figure]

Tại VD = 0,7V thì dòng xấp xỉ 0,01A → Chọn Ipa = 10mA

Sụt áp trên R5 là: VR5 = VCC − VD1 − VD2 = 16,6 (V)

→ R5 =

VR5

Ipa

= 1660(Ω)

→ Chọn R5 = 2kΩ/0, 25W

### 7.2 Tính chọn VR1 và Q5

7.2 Tính chọn VR1và Q5:
Dòng collector qua Q5: IC∕Q5 = IC∕Q6 = 10 ⋅ IB⁄Q3 = 10. 0,74 = 74 (mA)

VR1 =

VD1 + VD2 − VBE⁄Q5

IC⁄Q5

=

0,7 + 0,7 − 0,6
74. 10⁻³ = 108,1 (Ω)

→ Chọn VR1 = 200(Ω) rồi sau đó điều chỉnh

Do Q5 hoạt động chế độ A được dùng làm nguồn dòng nên công suất tiêu tán lớn nhất của nó là công suất tiêu tán tĩnh.

38

Điện áp DC trên tiếp giáp CE của Q5 là:

VCE∕Q5 = Vcc − VR1 − VBE∕Q3 − VBE∕Q1 − VR1

= 18 − (0,7 + 0,7 − 0,6) − 0,6 − 0,6 − 0,05.0,22

= 15,989 (V)

Vậy công suất tiêu tán tĩnh trên Q5 là:

PDC⁄Q5 = VCE⁄Q5

.IC⁄Q5 = 15,989.7,4. 10⁻³ = 0,12 W

Vậy ta chọn Q5 thỏa các điều kiện sau:

- IC ≥ (1,5 ÷ 2)ICp⁄Q5 = (11,1 ÷ 14,8) (mA)
- VCE ≥ (1,5 ÷ 2)VCE⁄Q5
= (23,9835 ÷ 31,978) (V)
- PC ≥ (1,5 ÷ 2)PDC⁄Q5 = (0,18 ÷ 0,24) (W)

=> Tra cứu Datasheet ta chọn Q5 là 2SA1013

Loại BJT | VCE0(V) | Pc(mW) | IC(A) | hfe | f(MHz) | Loại
2SA1013 | 160 | 900 | 1 | 60 : 320 | 50 | PNP

### 7.3 Tính chọn D3, D4, D5, VR2:

Để tránh méo tín hiệu xuyên tâm ổn định điểm làm việc cho các cặp BJT khuếch đại công suất thì Q1, Q2, Q3, Q4 phải làm việc ở chế độ AB. Ta dung D4, D5, D6, VR2 để phân cực cho các BJT.

Để Q1, Q2 làm việc ở chế độ dòng tĩnh IEQ = 50 Ma thì điện áp VBE của các BJT ở chế độ tĩnh là 0,6V

→ Chọn D3, D4, D5: là loại 1N4007

Ta có: VB3B4Q = VBE/Q3 + VBE/Q1 + VBE/Q2 + VBE/Q4 + VR1 + VR2 = 2,422 (V)

Chọn IC/Q5 = (3 ÷ 10)IB3P = 2, 24 ÷ 7, 4 (mA)

→ IC/Q5 = 6 (mA)

39

Từ đặc tuyến của diode ID = 6(mA) → VD = 0,66 (V)

→ VRV2 = VB3B4Q − 3VD = 2,422 − 3.0,66 = 0,442 (V)

Vậy RVR2 =

VVR2

IC/Q5

=

0,442
0,006

= 73,67 (Ω)

→ Chọn RV2 = 100 Ω sau đó hiệu chỉnh lại

### 7.4 Tính chọn R6, R7 và Q6:

Do Q6 làm việc chế độ A, để tránh suy giảm tín hiệu ta có thể chọn trước điện áp tĩnh trên điện trở hồi tiếp một chiều R6, R7 là 0,7 V.

Ta có: VR6 + VR7 = 0,7 V

Để tránh hồi tiếp âm quá nhiều làm giảm hệ số khuếch đại của Q6, ta chọn R7 > R6

R6 + R7 =

VR6 + VR7
7,4.10⁻³ = 94,5 (Ω)

→ Chọn: R6 = 43 Ω

R7 = 56 Ω

Với hai giá trị này của trở thì áp rơi trên hai điện trở này là: VR6R7 = (R6 + R7

).ICQ6

Điện thế trên cực C, E của Q6:

VCE
Q6

= VCC − VVR2 − VBE
Q4

− VBE
Q2

− VR6R7 = 16,09 (V)

Công suất tiêu tán tĩnh của Q6:

PttDC/Q6 = VCE/Q6.IC/Q6 = 16,09.6 = 96,53 (mW)

Từ những tính toán trên ta chọn Q6 phải thoả những điều kiện sau:

- IC ≥ (1,5 ÷ 2)IC/Q6 = (9 ÷ 12) (mA)
- VCE0 ≥ (1,5 ÷ 2)VCC = (27 ÷ 36) (V)
- PC ≥ (1,5 ÷ 2) ∑ Pttmax/Q6 = (144,8 ÷ 193) (mW)

40

→ Tra cứu Datasheet ta chọn Q6 là 2SC2383:

Loại BJT | VCE0 (V) | Pc(mW) | IC (A) | hfe | f (MHz) | Loại
2SC2383 | 160 | 900 | 1 | 60-320 | 100 | NPN

### 7.5 Tính chọn các tụ C1 và C6:

Nguyên tắc tính chọn các tụ là giá trị trở kháng của tụ (tại tần số nhỏ nhất trong

băng thông) phải nhỏ hơn nhiều so với giá trị trở kháng tổng (thông thường ta

chọn nhỏ hơn hoặc bằng 1/10)
Chọn tần số fmin = 40Hz

7.5.1 Tụ C1

Tụ C1 là tụ thoát xoay chiều Q6

Chọn XC1 =

1
10

R7 = 6,8

→ C1 =

1
2πfXC1

= 468 (μF)

→ Chọn C1 = 470μF/50V

7.5.2 Tụ C6:
Tụ C6 là tụ chống dao động tự kích và quyết định cắt tần số cắt trên của mạch. Vì tụ có chức năng cắt dãy tần cao nên điện dung của tụ sẽ nhỏ. Giá trị C6 nằm trong khoảng 10pF - 1nF cho hầu hết các ứng dụng của khuếch đại âm tần

→ Chọn C6 = 100 (pF)

CHƯƠNG 8: TÍNH TOÁN TẦNG ĐẦU VÀO ĐƠN VÀ HỒI TIẾP

Chọn βQ6 = 150

→ IB/Q6 =

IC/Q6

βQ6

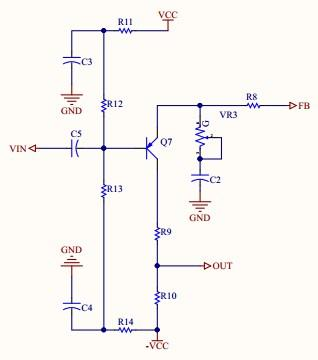
[picture p37: figure]

= 49 (μA)

Để không ảnh hưởng đến điểm làm việc Q7, ta chọn ICQ7 ≫ IBQ6 → IC/Q7 = 10.IB/Q6 = 10.49. 10⁻⁶ = 0.49 (mA)

### 8.1 Tính chọn R8:

Chọn VR8 = (

1
10

÷

1
20

)VCC = (0,9 ÷ 1,8) (V)

R8 =

VR8

IC/Q7

= (1,83 ÷ 3,6) (kΩ)

→ Chọn R8 = 2, 4 (kΩ)

### 8.2 Tính chọn R10:

Ta có: IR10 = ICQ7 − IBQ6 = 0,44 (mA)

VR10 = VBE

Q6

+ VR6R7 = 0,6 + 0,7 = 1,3 (V)

→ Chọn R10 = 3 (kΩ)

### 8.3 Tính chọn R9:

Vì Q7 hoạt động chế độ A, để Q7 khuếch đại không bị méo và có

biên độ đủ lớn thì điểm tải tĩnh phải nằm giữa đường tải động

Ta chọn VCE/Q7 = 9 (V)

VR9 = VCC − VR8 − VCE/Q7 − VR10

= 18 − 0,98 − 9 − 1,3 = 6,72 (V)

→ R9 =

VR9

ICQ7

= 13,57 (kΩ)

→ Chọn R9 = 12 (kΩ)

### 8.4 Tính chọn Q7

Ta có: PttDC/Q7 = VCE/Q7.IC/Q7 = 9.0,49.0,001 = 0,0045 (W)

Chọn Q7 thoả mãn các điều kiện sau:

- IC ≥ (1,5 ÷ 2)IC/Q7 = (0,73 ÷ 0,98) (mA)
- VCE ≥ (1,5 ÷ 2)VCC = (27 ÷ 36)(V)
- PC ≥ (1,5 ÷ 2)Pttmax/Q7 = (6,75 ÷ 9) (mW)

→ Tra cứu Datasheet ta chọn Q7 là 2SA1015

Loại BJT | VCE0 (V) | Pc(mW) | IC (A) | hfe | f (MHz) | Loại
2SA1015 | 50 | 400 | 0,15 | 120:240 | 80 | PNP

### 8.5 Tính chọn R11, R12, R13, R14:

Ta có: VR13 + VR14 = VB/Q7 = VEQ7 − VBE/Q7

VEQ7 = VCC − VR8 = 18 − 0,98 = 17,02 (V)

→ VR13 + VR14 = 17,02 − 0,6 = 16,42 (V)

Chọn βQ7 = 200

Ta có: IB/Q7 =

IC/Q7

βQ7

=

0,49.0,001
200

= 2,46 (μA)

Chọn IR13 + IR14 ≥ 10.IB/Q7 = 12. 2,46. 10⁻⁶ = 29,62 (μA)

→ R13 + R14 =

VR13+VR14

IR13+IR14

=

16,42
29,62.10⁻⁶ = 554,3 (kΩ)

Chọn sụt áp qua R14 = 6V

→ R14 =

6
29,62.10⁻⁶ = 202,6 (kΩ)

Vậy chọn R14 = 200 (kΩ)

R13 = 554,3 − 202,6 = 351,7 (kΩ)

Chọn R13 = 330 (kΩ)

Trở kháng vào toàn mạch:

Zin =

R13. R12
R13 + R12

=

330. R12
330 + R12

= 200 (kΩ)

→ R12 = 507,7 (kΩ)

→ Chọn VR5 = 1 (MΩ) thay cho R12 sau đó hiệu chỉnh lại

VR11 = 2. VCC − VR12 − VR13 − VR14 = 2.18 − 510. 10³

. 29,62. 10⁻⁶ − 16,42
= 4,5(V)

→ R11 =

VR11

IR14+IR13

= 150 (kΩ)

→ Chọn R11 = 200 (kΩ)

### 8.6 Tính chọn VR3

Hệ số khuếch đại của mạch AV

′ =

VL

Vin

= 11,12

Hệ số khuếch đại khi có hồi tiếp AVℎt =

VR3
VR3+R8

=

1
A′V

= 0,089

→ VR3 = 234,5

→ Chọn VR3 = 470 (Ω) sau đó tinh chỉnh lại

### 8.7 Tính chọn tụ C2, C3, C4 và C5

8.7.1 Tụ C2

Tụ C2 thoát xoay chiều cho cầu hồi tiếp VR3, R8.

Chọn XC2 =

1
10

VR3 =

1
10

. 276 = 27,6 (Ω)

→ C2 =

1
2πf.XC2

= 115,3 (μF)

→ Chọn C2 = 220μF/50V

8.7.2 Tụ C3, C4
Tụ C3, C4 là tụ lọc nguồn tầng nhận tín hiệu vào.

Chọn XC3 =

1
10

R11 =

200
10

= 20 (kΩ)

→ C3 =

1
2πf XC3

= 0,15 μF

→ Chọn C3 = C4 = 0, 1 μF

8.7.3 Tụ C5
Tụ C5 là tụ liên lạc nối tín hiệu điện áp và tầng nhận tín hiệu vào, ngăn dòng DC.

Chọn XC5 =

1
10

Zin =

200
10

= 20 (kΩ)

→ C5 =

1
2πf.XC5

= 0,159 μF

→ Chọn C5 = 0, 47μF

CHƯƠNG 9: TÍNH TOÁN CÁC MẠCH PHỤ TRỢ

### 9.1 Tính toán mạch bảo vệ

9.1.1 Tính chọn Q8, Q9

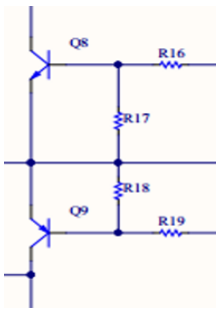
[picture p38: figure]

Dòng đỉnh qua R1, R2: IE/Q1 = 2,79 + 10%. 2,79 = 3,069 (A)

Chọn dòng để mạch bảo vệ hoạt động là: IE1 = 5 (A)

Sụt áp trên R1: VR1 = IE1. R1 = 1.1 (V)

Chọn dòng tĩnh: ICQ/Q8 = ICQ/Q9 = 1 (mA)

Ta có:

VCE/Q8 = VCE/Q9 = VBE/Q3 + VBE/Q1 + VR1 = 0,6 + 0,6 + 1,1 = 2,3(V)

Công suất tiêu tán trên Q8, Q9 là

PttQ8 = PttQ9 = VCE/Q8

.ICQ/Q8 = 2,3 (mW)

Chọn Q8, Q9 thỏa mãn những điều kiện sau

- IC ≥ (1,5 ÷ 2)ICQ/Q8 = (1,5 ÷ 2) (mA)
- VCE ≥ (1,5 ÷ 2)VCE/Q8 = (3,45 ÷ 4,6) (V)
- P ≥ (1,5 ÷ 2)PttQ8 = (3,45 ÷ 4,6) (mW)

Tra cứu Datasheet ta chọn 2SC1815 và 2SA1015
Loại BJT | VCE0(V) | PC(mW) | IC(mA) | hfe | f (MHz)
2SC1815 | 50 | 400 | 150 | 70:140 | 80
2SC1015 | 50 | 400 | 150 | 70:140 | 80

9.1.2 Tính R16, R17, R18, R19

Chọn βQ8 = 70

Dòng tĩnh cực B của Q8: IBQ/Q8 =

ICQ/Q8

βQ8

= 0,014 (mA)

Dòng qua R16, R17: IR16 ≫ IBQ

Q8

→ IR16 = 15IBQ/Q8 = 0,21(mA)

Khi mạch hoạt động bình thường thì Q8, Q9 tắt nên:

→ VR1max = IR1max. R1 = 0,614 (V)

Chọn VBEQ8 = VBEQ9 = 0,4 (V)

R16 + R17 =

VR1max

IR16

= 2922,8 (Ω)

R17 =

VBE/Q8

IR16

= 1904,8 (Ω)

→ R16 = 1018 (Ω)

Chọn R17 = R18 = 2 (kΩ)

R16 = R19 = 1, 5 (kΩ)

### 9.2 Tính toán mạch lọc Zobel

Ta có: ZL = (R15 +

1
jωC) // (RL + jωL)

=

(R15+

1
jωC)

).(RL+jωC)

R15+

1
jωC+RL+jωC

=

R15.RL+R
15.jωL+

RL
jωC+

L
C
R15+

1
jωC+RL+jωL

Để không phụ thuộc vào tần số thì ZL = RL

→ R15. RL + R15.jωL +

RL
jωC

+

L
C

= R15. RL +

RL
jωC

+ RL² + jωL. RL

→ {

L
C

= RL²
R15.jωL = jωL. RL → R15 = RL = 4 (Ω)

Vì L của loa thường rất nhỏ ≈ 0,1 μH → CX =

L
RL² = 6,25 (nF)

Chọn CX = 10 (nF); R15 = 4 (Ω)

CHƯƠNG 10: HỆ SỐ KHUẾCH ĐẠI CỦA MẠCH & MÉO PHI TUYẾN

β0 = βF(1 +

VCE
VA

)

rπ =

β0
gm

r0 =

VA + VCE
IC

Phân tích mạch ở chế độ AC:

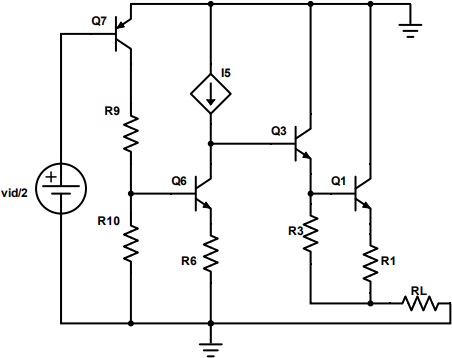
[picture p39: figure]

Sơ đồ tương đương cho chế độ AC:

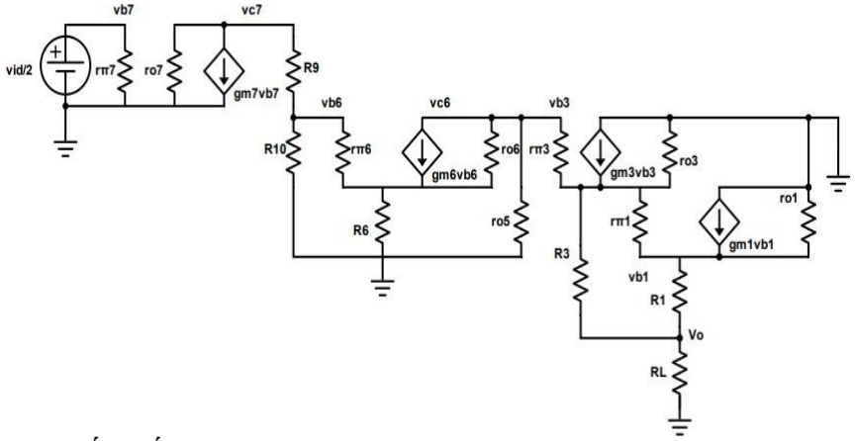
[picture p40: figure]

### 10.1 Hệ số khuếch đại Q6

Hệ số khuếch đại vòng hở của mạch được tính bằng công thức: A0 = Avt1Avt2Avt3

Ta có: Req1 = (Bo3 + 1)[R3//(rπ1 + R1

). RL(gm1 +

1

rπ1

+

1

rπ3

)

= (204 + 1)[220//(0,0374. 10³ + 0,22) + 4].4

= 60078,8 Ω

Tính hệ số khuếch đại tầng thúc Avt2

Avt2 =

vc6

vb6

vc6 = −gm6vb6

(ro6 + R6

)// r05//Req1

=> Avt2 = −gm6[(ro6 + R6

)// r05//Req1]

= −0,296.[(9,189. 10³ + 36)//9,189. 10³ //60078,8]

= −1265,65

Tính hệ số khuếch đại tầng đầu vào Avt1

Avt1 =

vc7

vb7

vc7 = −gm7vb7{ro7//[R9 + R10//(rπ6 + R6

(βo6 + 1))]}

=> Avt1 = −gm7{ro7//[R9 + R10//(rπ6 + R6

(βo6 + 1))]}

= −0,0196{138,776. 10³

//[15000 + 3000//(0,75. 10³ + 36(204 + 1))]}

= −299,81

Do tầng công suất mắc theo kiểu C chung, chỉ khuếch đại dòng, nên: Avt3 = 1

=> Ao = Avt1Avt2Avt3 = −299,81. −1265,65 = 379455,5

### 10.2 Kiểm tra méo phi tuyến

Trong mạch các BJT làm việc ở chế độ A, chỉ có Q1, Q2 làm việc ở chế độ AB nên méo phi tuyến trong mạch chủ yếu do Q1, Q2 quyết định.

Giả sử tín hiệu vào là hình sin và Vin = 0,775V. Lúc này điện áp đặt lên tiếp giáp BE của Q1:

VBE1

(t) = VBE1Q + VBEmsinωt

Có VBE1Q = 0,6V. VBEm = VBE1p − VBE1Q =0,86 – 0,6 = 0,26V

Gọi IC0 là dòng rỉ của Q1, Q2: IC = IC0. e

VBE1Q
VT . e

VBEmsinωt
VT

Khai triển y = e

VBEmsinωt
VT theo chuỗi Taylor:

y = 1 +

| VBEm
| VT sinωt +
| 1
| 2 (

VBEm
VT )

2

. sin²ωt + ⋯

Méo phi tuyến chủ yếu do hài bậc cao gây ra. Loại hài bậc cao và biến đổi sin²ωt =

1−cos2ωt
2

, ta được:

y = 1 +

| 1
| 4 VBEm
| 2
| VT² + VBEm
| VT sinωt −

1
4

(

VBEm
VT )

2
cos2ωt

Theo định nghĩa méo phi tuyến: γ =

√∑ | I im
n | 2
i=2

I1m
Trong đó: + I1m:thành phần dòng cơ bản

+ Iim: biên độ hài.

Loại bỏ các hài bậc cao ta được:

γ =

I2m

I1m

=

VBEm
4VT2
VBEm
VT

=

VBEm
4VT

Khi chưa có hồi tiếp: γ =

VBEm
4VT

=

0,26
4.0,025

= 2,6

Khi có hồi tiếp: γ

′ =

γ
(1+gmRL)g

g: độ sâu hồi tiếp: g = (1 + Av
. Av.ℎt

) =

Av
A′v

= 1674,7

gm hỗ dẫn: gm =

βQ1
rbe/Q1

=

IE1Q
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
(1 + gmRL)g

= 0,015% < 0,3%

→ Đáp ứng yêu cầu của đề bài

PHẦN 3: MÔ PHỎNG VÀ THI CÔNG

### 1. Giá trị linh kiện sau khi tính toán

STT | Vị trí trong sơ đồ mạch | Giá trị linh kiện
1 | Q1 | 2SD718
2 | Q2 | 2SB688
3 | Q3 | TIP41C
4 | Q4 | TIP42C
5 | Q5 | 2SA1013
6 | Q6 | 2SC2383
7 | Q7 | 2SA1015
8 | R1, R2 | 0,22Ω/2W
9 | R3, R4 | 220 Ω/2W
10 | R5 | 2k Ω
11 | R6 | 43 Ω
12 | R7 | 56 Ω
13 | R8 | 2,4k Ω
14 | R9 | 12k Ω
15 | R10 | 3k Ω
16 | R11 | 200k Ω
17 | R12 | 510k Ω
18 | R13 | 330k Ω
19 | R14 | 200k Ω
20 | R15 | 4,3 Ω
21 | D1,D2,D3,D4,D5 | 1N4007 x
22 | VR1 | 200 Ω
23 | VR2 | 100 Ω
24 | VR3 | 470 Ω
25 | VR4 | 1k Ω
26 | C1 | 470μF
27 | C2 | 220 μF
28 | C3 | 0,1 μF
29 | C4 | 0,1 μF
30 | C5 | 0,47 μF
31 | C6 | 100Pf
32 | C7 | 10 μF

### 2. Sơ đồ sau khi tính toán hoàn chỉnh

2.1 Mô phỏng DC

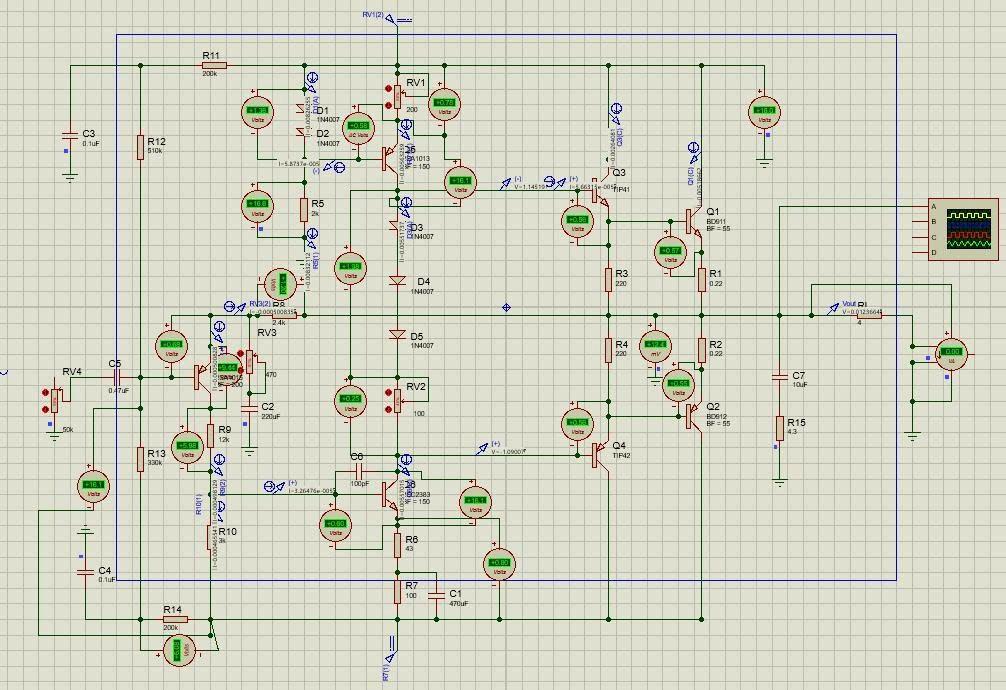
[picture p41: figure]

Tổng thể mạch khi phân cực tĩnh:

- Đã điều chỉnh đúng điểm giữa = 12,4 (mV)
- Nguồn dòng 0,0056 (A)
- Các giá trị điện áp dòng điện khá chính xác với phần tính toán, ít sai số 2.2 Mô phỏng AC

*Mô phỏng dạng sóng BJT nguồn dòng Q5 và BJT thúc Q6

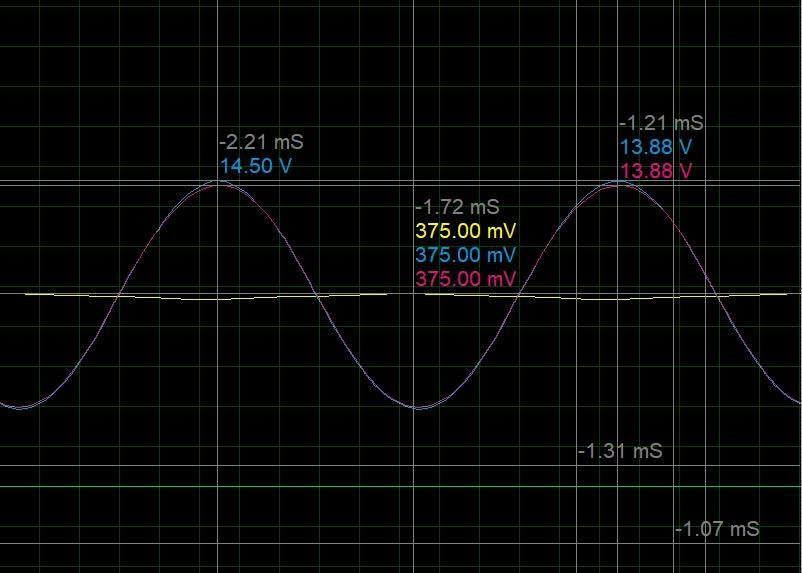
[picture p42: figure]

*Mô phỏng dạng sóng BJT tầng vào Q7

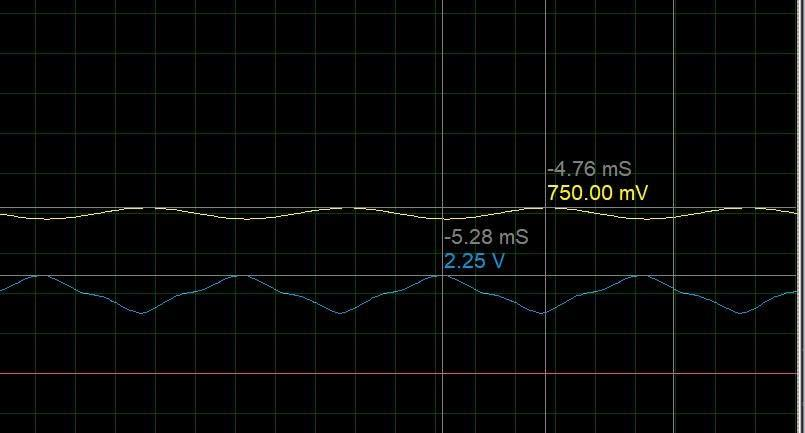
[picture p43: figure]

* Mô phỏng dạng sóng ngõ ra

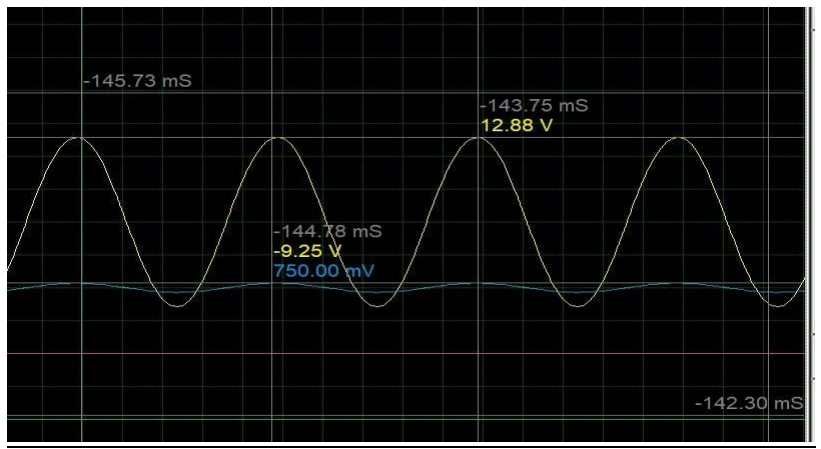
[picture p44: figure]

- Biên độ của tín hiệu vào dạng sine, f = 1kHz (màu xanh): 0,7V
- Biên độ của tín hiệu ra (màu vàng): 12,88V

Nhận xét:

- Tín hiệu ra dạng chuẩn sine, sóng ở đỉnh không bị xén
- Gía trị biên độ được khuếch đại lên lớn, khoảng 18 lần

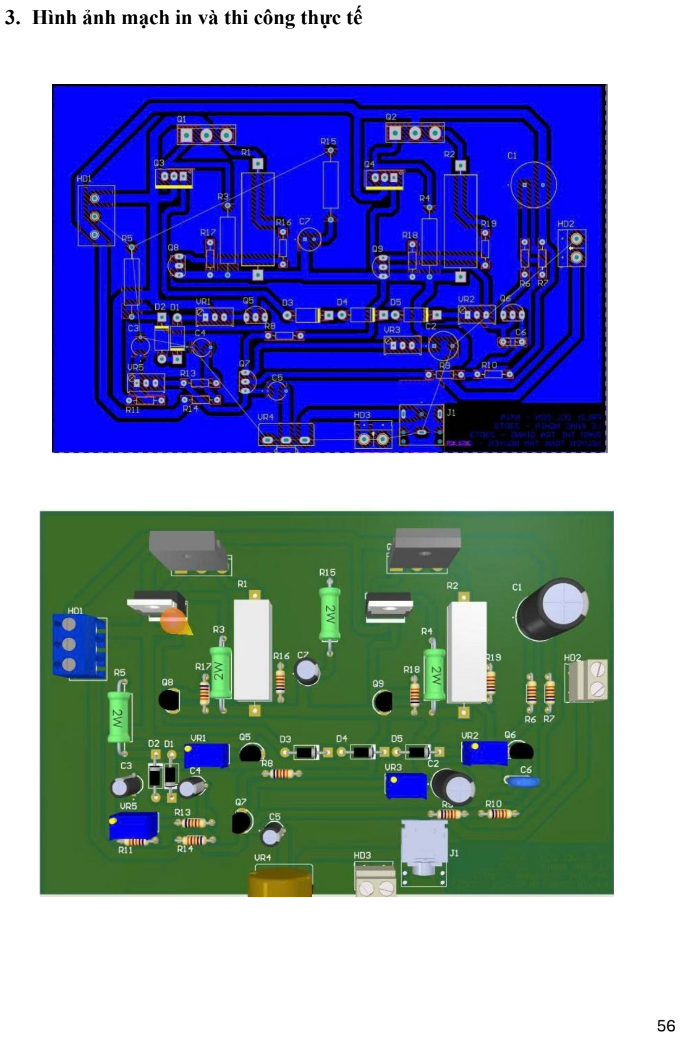
[picture p45: page 57]

### 3. Hình ảnh mạch in và thi công thực tế

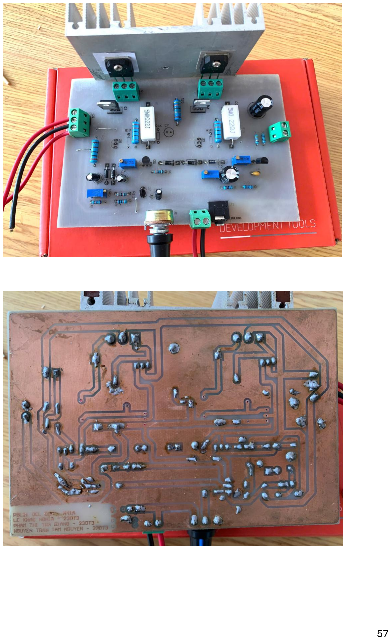
[picture p46: page 58]

### 4. Bảng so sánh thông số khi chưa có tín hiệu AC

Thông số Q7 | VBE | VCE
Mô phỏng | 0,64V | 8,65V
Thực tế | 0,633V | 8,44V
Thông số Q6 | VBE | VCE
Mô phỏng | 0,61V | 16,92V
Thực tế | 0,64V | 17,3V
Thông số Q5 | VBE | VCE
Mô phỏng | 0,6V | 16,89V
Thực tế | 0,645V | 17,25V
Thông số Q4 | VBE | VCE
Mô phỏng | 0,57V | 18,5V
Thực tế | 0,578V | 18,72V
Thông số Q3 | VBE | VCE
Mô phỏng | 0,57V | 18,42V
Thực tế | 0,58V | 18,64V
Thông số Q2 | VBE | VCE
Mô phỏng | 0,63V | 18,5V
Thực tế | 0,597V | 18,72V
Thông số Q1 | VBE | VCE
Mô phỏng | 0,62V | 18,9V
Thực tế | 0,6V | 19,3V

### 5. Kiểm tra khả năng đáp ứng băng thông của mạch

*Mô phỏng


Nhận xét:

- Tín hiệu ra không bị méo, suy hao ít nên hoạt động tốt trong vùng tần số từ 15 đến 50kHz

→ Đáp ứng yêu cầu đề bài đặt ra

*Thực tế

f = 50Hz

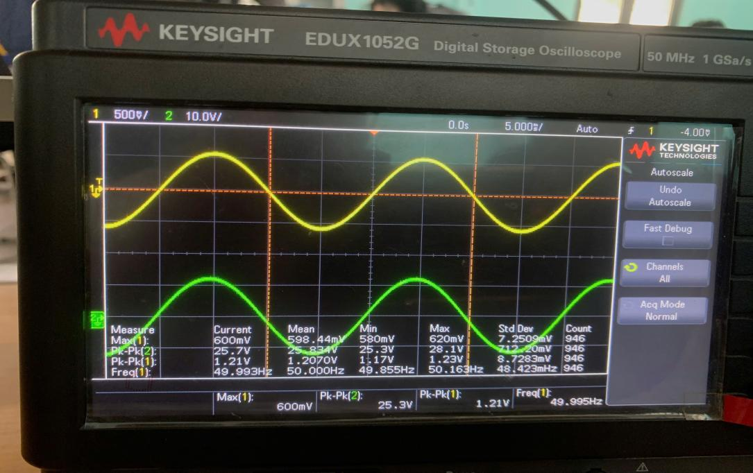
[picture p47: figure]

Nhận xét:
Ở tần số f = 50Hz thì Vin = 1,21(V);Vout = 25,3(V) thì ta có hệ số khuếch đại AV =

Vout

Vin

=

25,3
1,21

= 20,9

→ Sóng ra không bị xén, nhiễu và đáp ứng yêu cầu đề bài

f = 15kHz

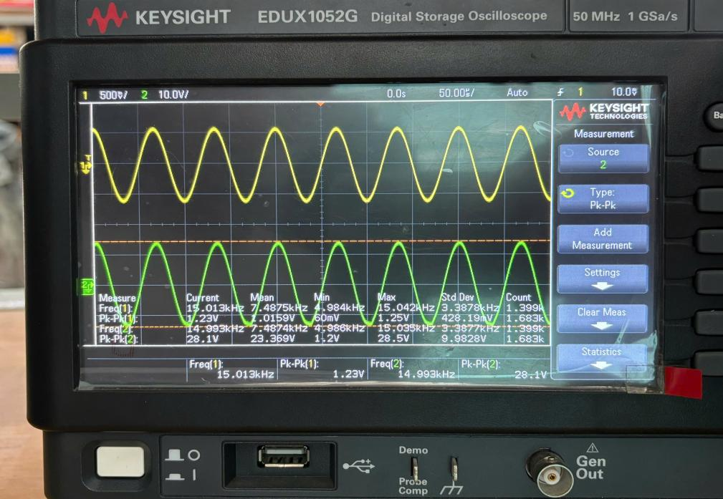
[picture p48: figure]

Nhận xét:
Ở tần số f = 15kHz thì Vin = 1,23(V);Vout = 28,1(V) thì ta có hệ số khuếch đại AV =

Vout

Vin

=

28,1
1,23

= 22,85

→ Sóng ra không bị xén, nhiễu và đáp ứng yêu cầu đề bài

PHẦN 4: ĐÁNH GIÁ KẾT QUẢ ĐẠT ĐƯỢC VÀ HƯỚNG PHÁT TRIỂN

### 1. Những kết quả đạt được

Sau những tháng miệt mài làm việc, với sự hướng dẫn tận tình của thầy Huỳnh Thanh Tùng và Thầy Vũ Vân Thanh và các anh chị trong khoa Điện tử - Viễn thông nhóm chúng em đã đạt được những kết quả sau:

- Thiết kế và chế tạo được mạch khuếch đại công suất âm tần OCL - 15W có khả năng sử dụng rộng rãi.
- Đạt được những mục tiêu và yêu cầu ban đầu.
- Vận dụng được nhiều kiến thức về khuếch đại công suất trong quá trình thi công.
- Tìm hiểu được nhiều mẫu có thể sử dụng sau này.
- Khả năng tìm tài liệu trên mạng.
- Khả năng làm việc theo nhóm.

### 2. Thuận lợi và khó khăn

Thuận lợi:

- Nhờ trang thiết bị của nhà trường tạo điều kiện cho nhóm trong quá trình thiết kế và thi công.
- Được sự hướng dẫn tận tình của Huỳnh Thanh Tùng, Thầy Vũ Vân Thanh và các anh chị khóa trước trong suốt khoảng thời gian thiết kế và thi công vừa qua.

Khó khăn:

- Thời gian thực hiện bị giới hạn.
- Gặp nhiều vấn đề trong việc tìm tài liệu tham khảo.
- Mất nhiều thời gian cho việc thiết kế vì phải lựa chọn nhiều phương án nhằm đáp ứng yêu cầu đề ra ban đầu.

### 3. Hướng phát triển

Dựa vào những kinh nghiệm đã tích góp được trong quá trình làm việc nhóm, thiết kế và thi công mạch, trong tương lai chúng em sẽ cố gắng hạn chế đến mức tối thiểu những sai sót không đáng có để những dự án tiếp theo được hoàn thiện một cách tốt nhất.

### 4. Tài liệu tham khảo

- Sách Microelectronic Circuit Design 4th edition – Richard C. Jaeger, Travis
N. Blalock.
- Giáo trình, slides bài giảng, vở ghi học phần Kỹ thuật mạch điện tử -PGT.TS Nguyễn Văn Tuấn, khoa Điện Tử - Viễn Thông, trường Đại học Bách khoa – Đại học Đà Nẵng.
- Giáo trình, slides bài giảng, vở ghi học phần Cấu kiện điện tử - TS. Huỳnh Thanh Tùng, khoa Điện Tử - Viễn Thông, trường Đại học Bách khoa – Đại học Đà Nẵng.
- File tham khảo thiết kế OTL ngõ vào đơn của giảng viên Nguyễn Văn Tuấn, khoa Điện Tử - Viễn Thông, trường Đại học Bách khoa – Đại học Đà Nẵng.
- Đồ án môn học nhóm HP 18N39, Thiết kế mạch khuếch đại công suất OCL 25W, ngõ vào đơn - Trường Đại học Bách khoa – Đại học Đà Nẵng.
- Slides bài giảng môn Cơ sở kỹ thuật điện – Khoa Điện, Điện tử - Đại
học Sư phạm Kỹ thuật TP.HCM
- Trang web http://www.alldatasheet.com , http://www.snapeda.com

### 5. Phần phụ lục

Các datasheet của các linh kiện được sử dụng trong báo cáo

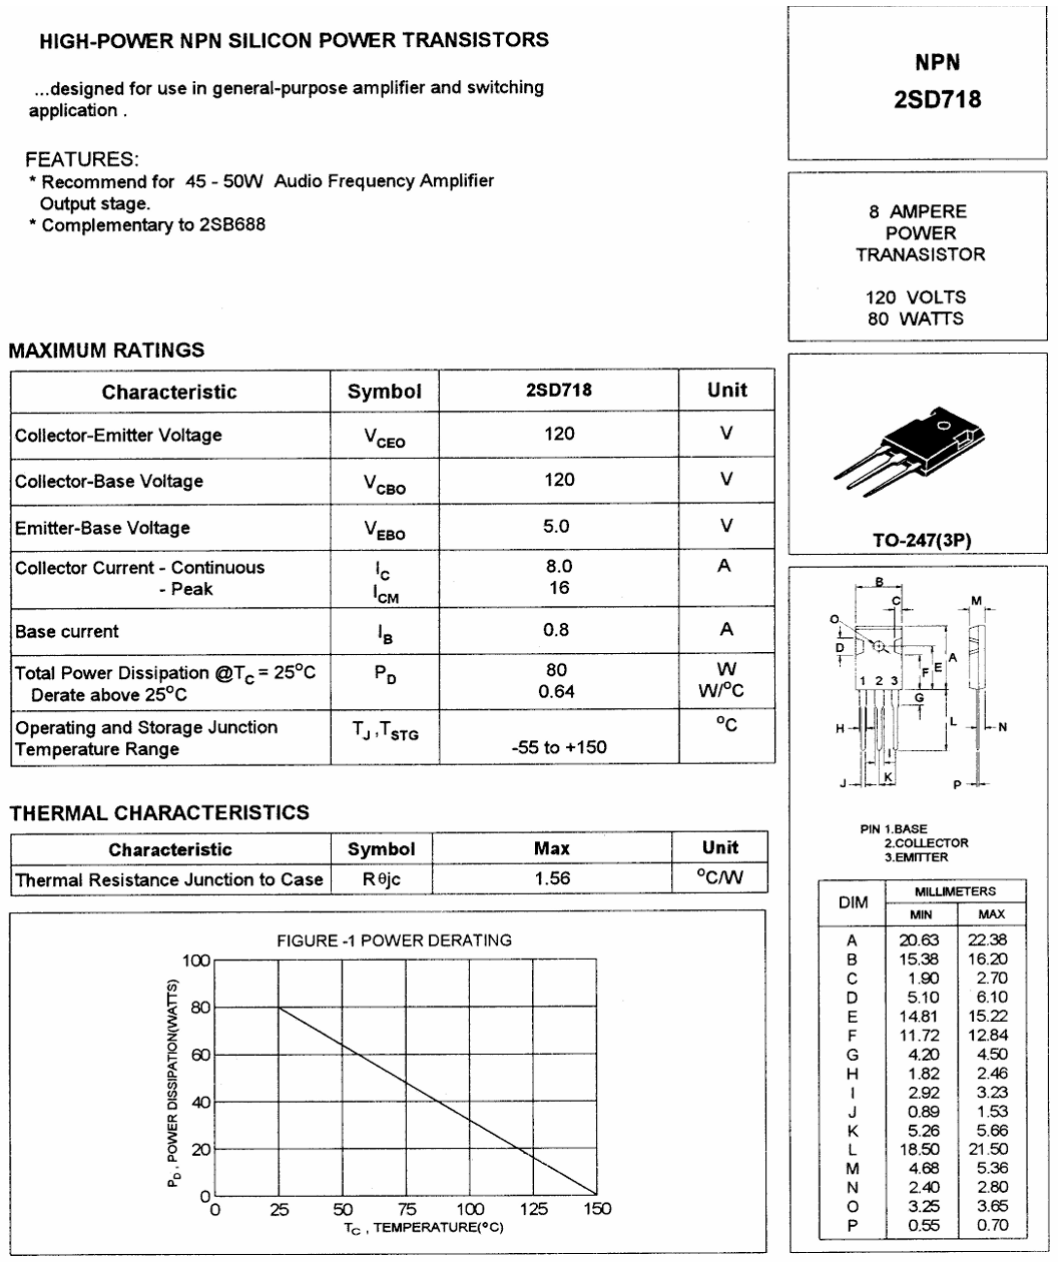
[picture p49: figure]

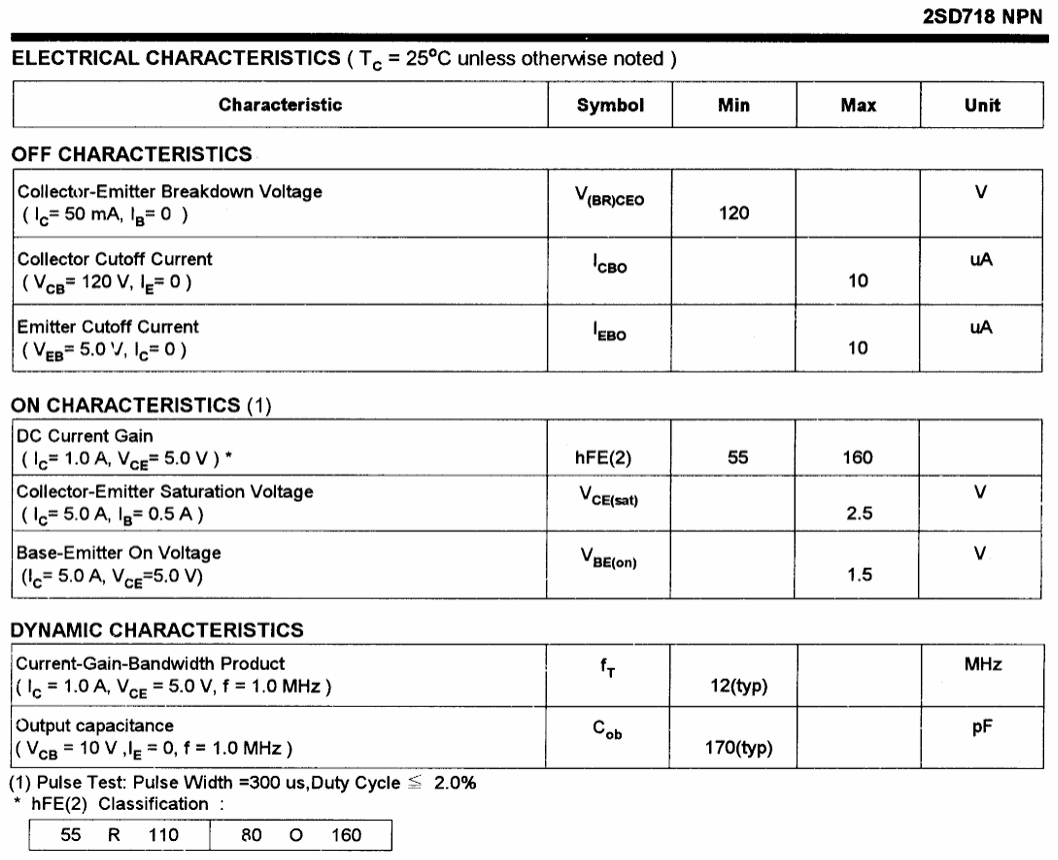
[picture p50: figure]

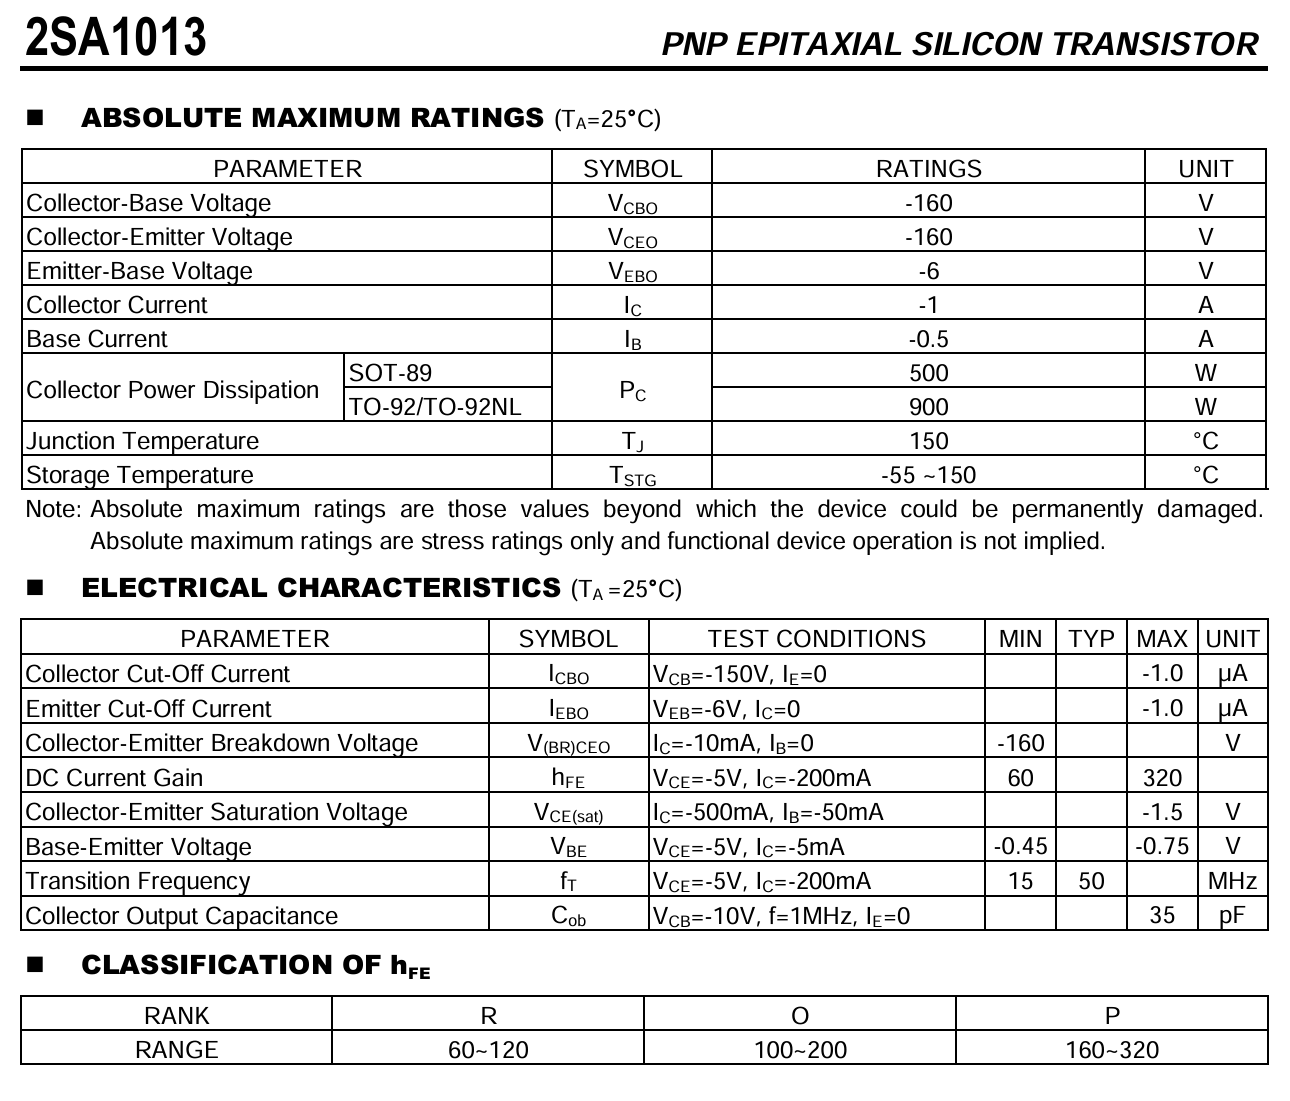
[picture p51: figure]

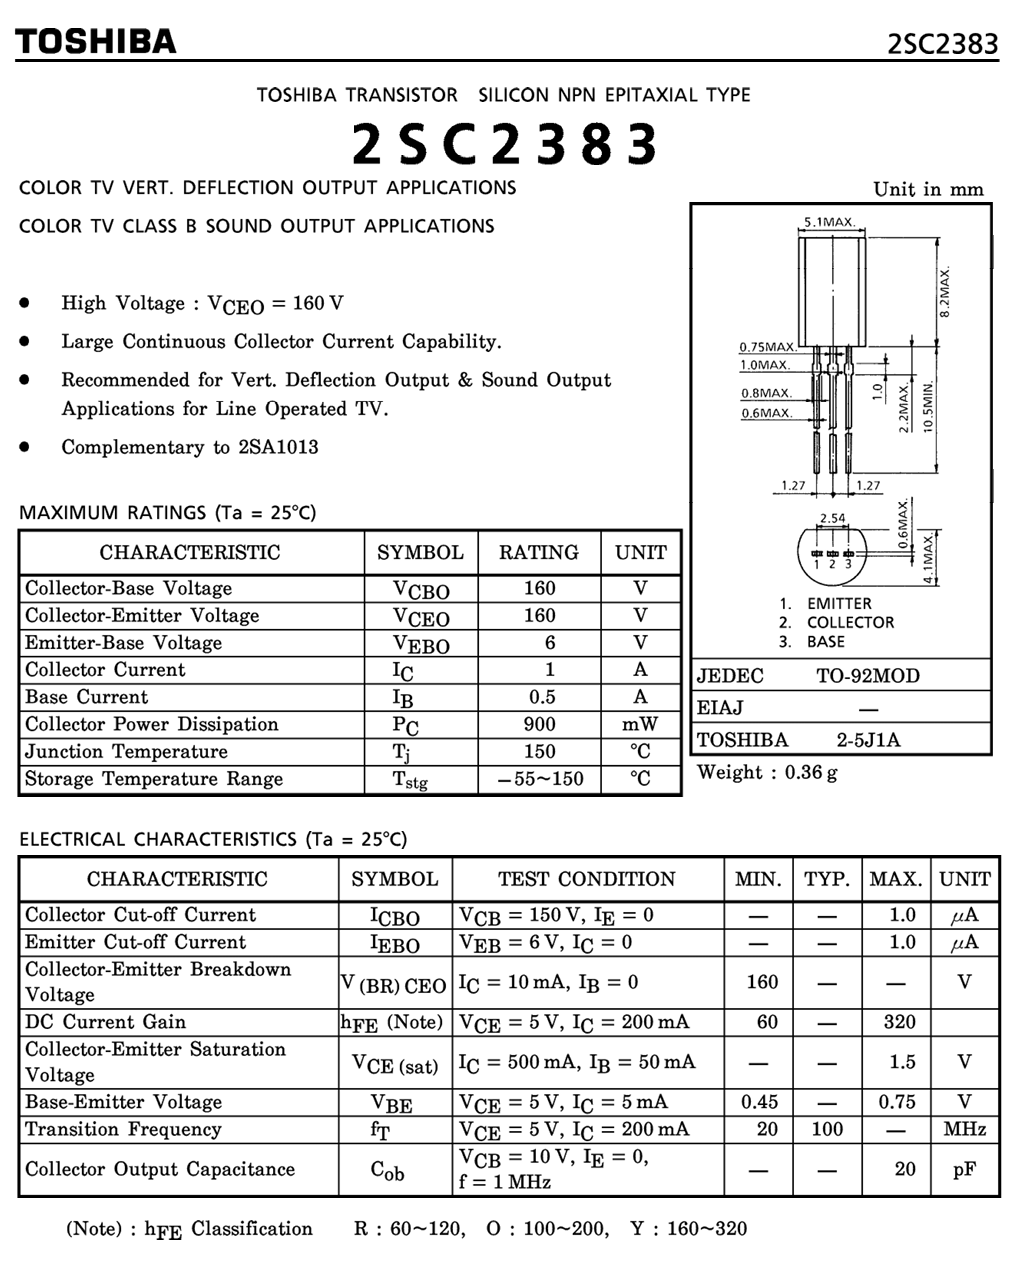
[picture p52: figure]

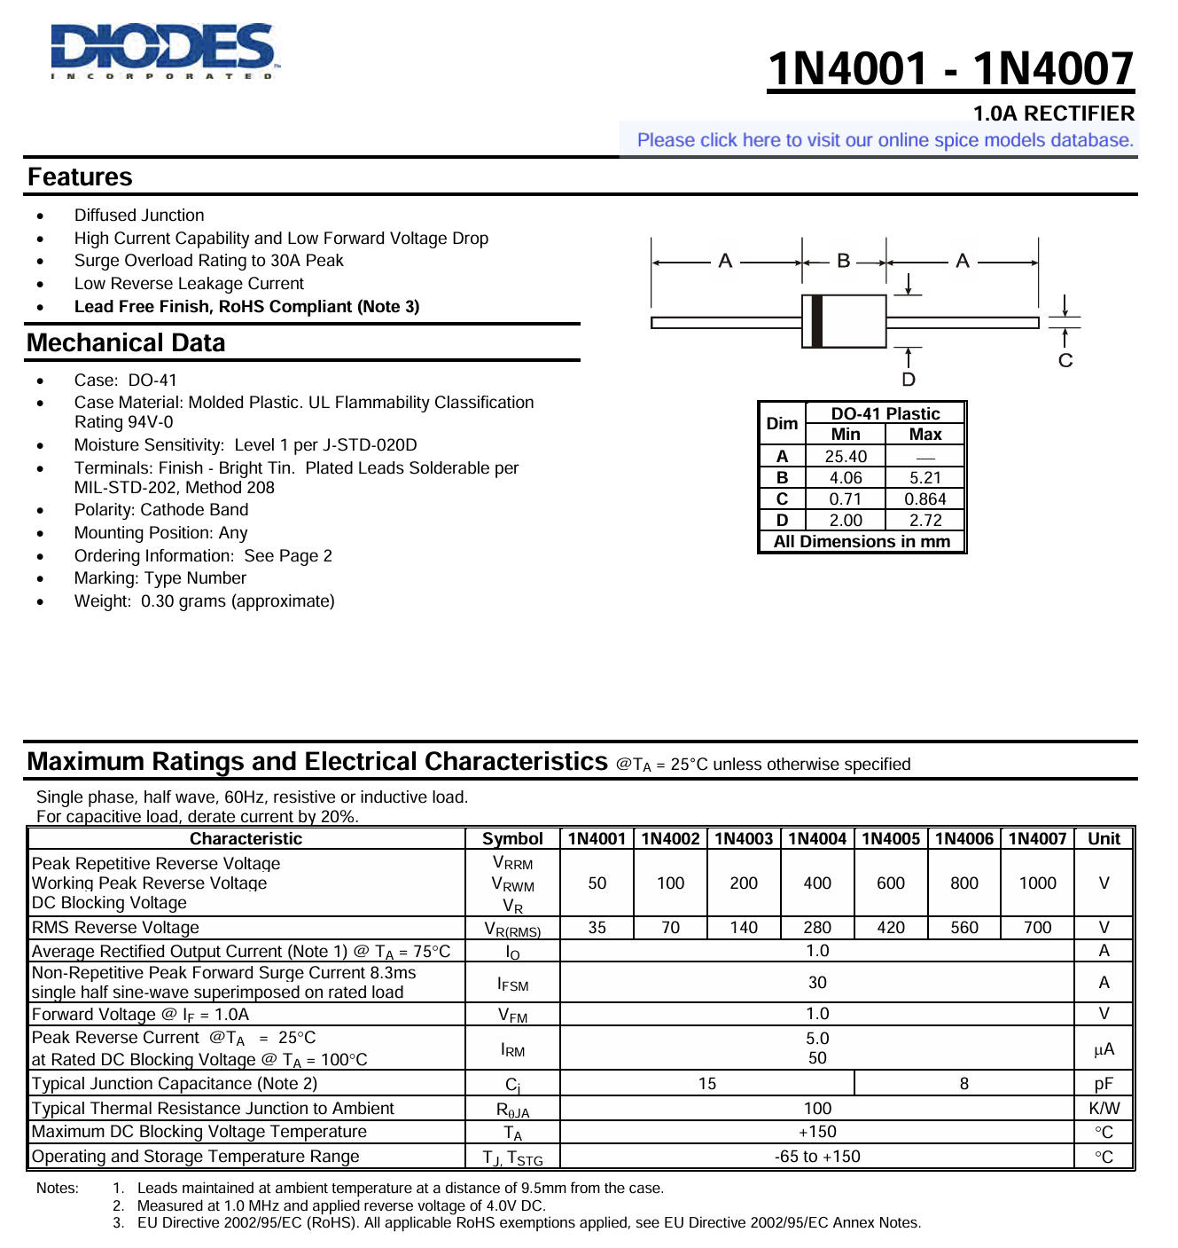
[picture p53: figure]

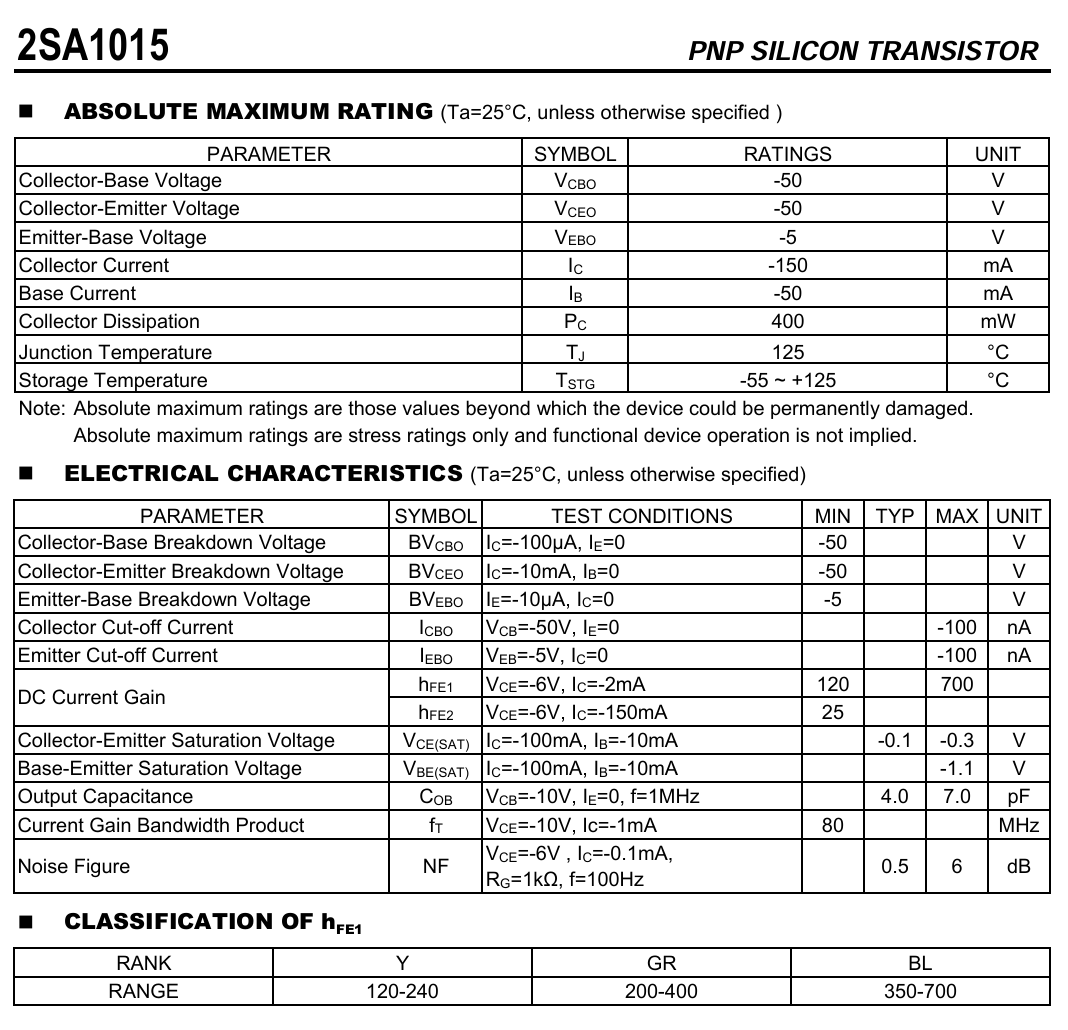
[picture p54: figure]

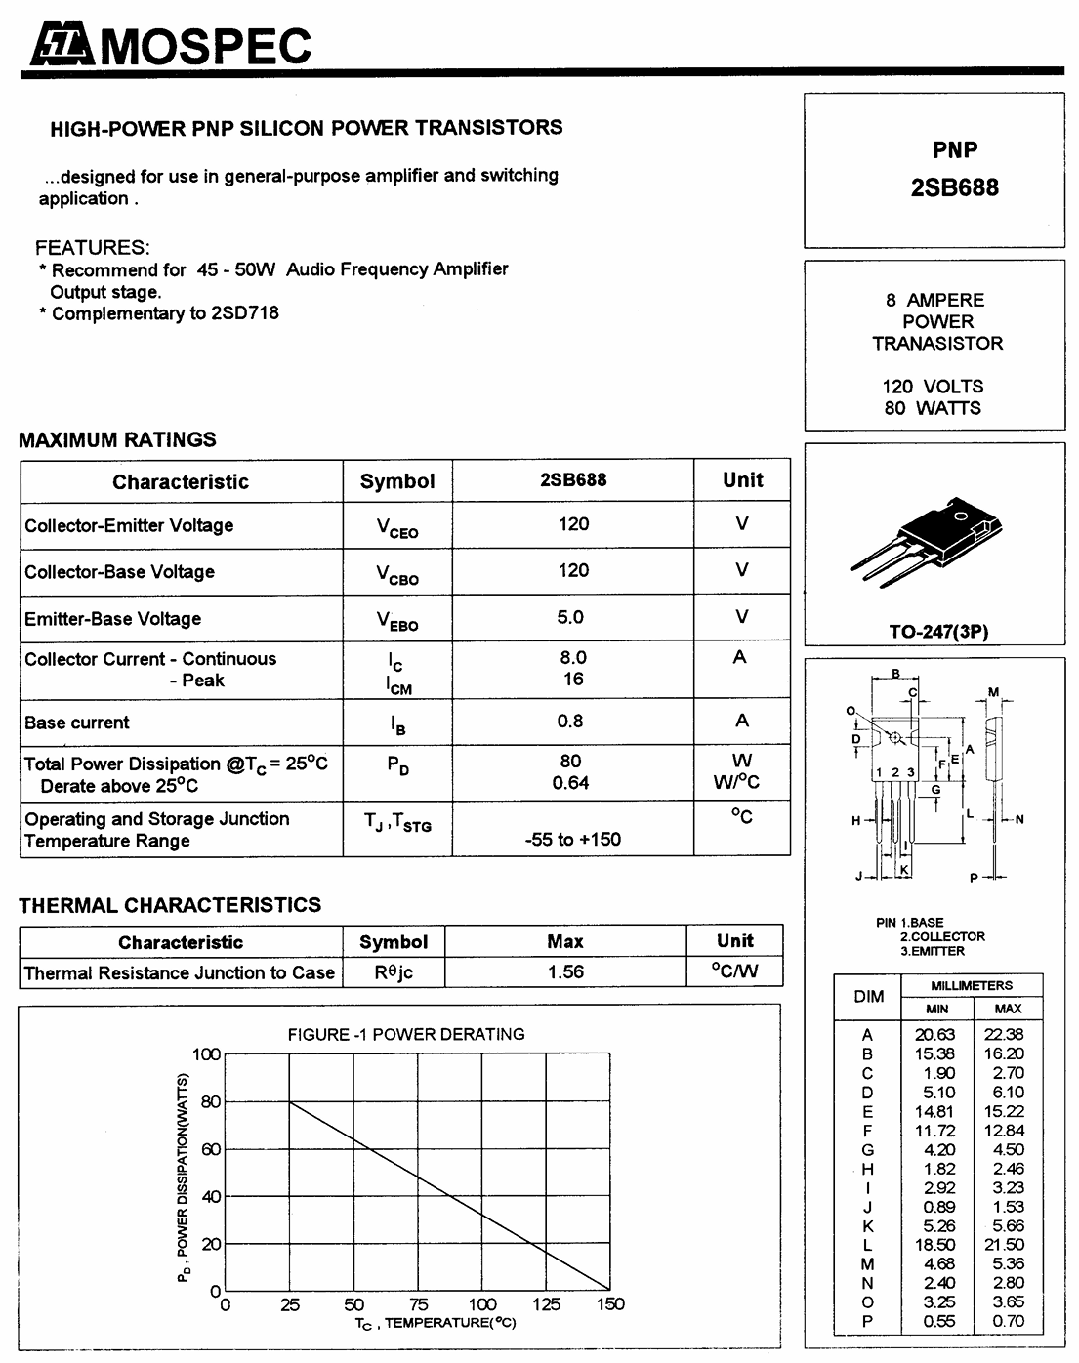
[picture p55: figure]
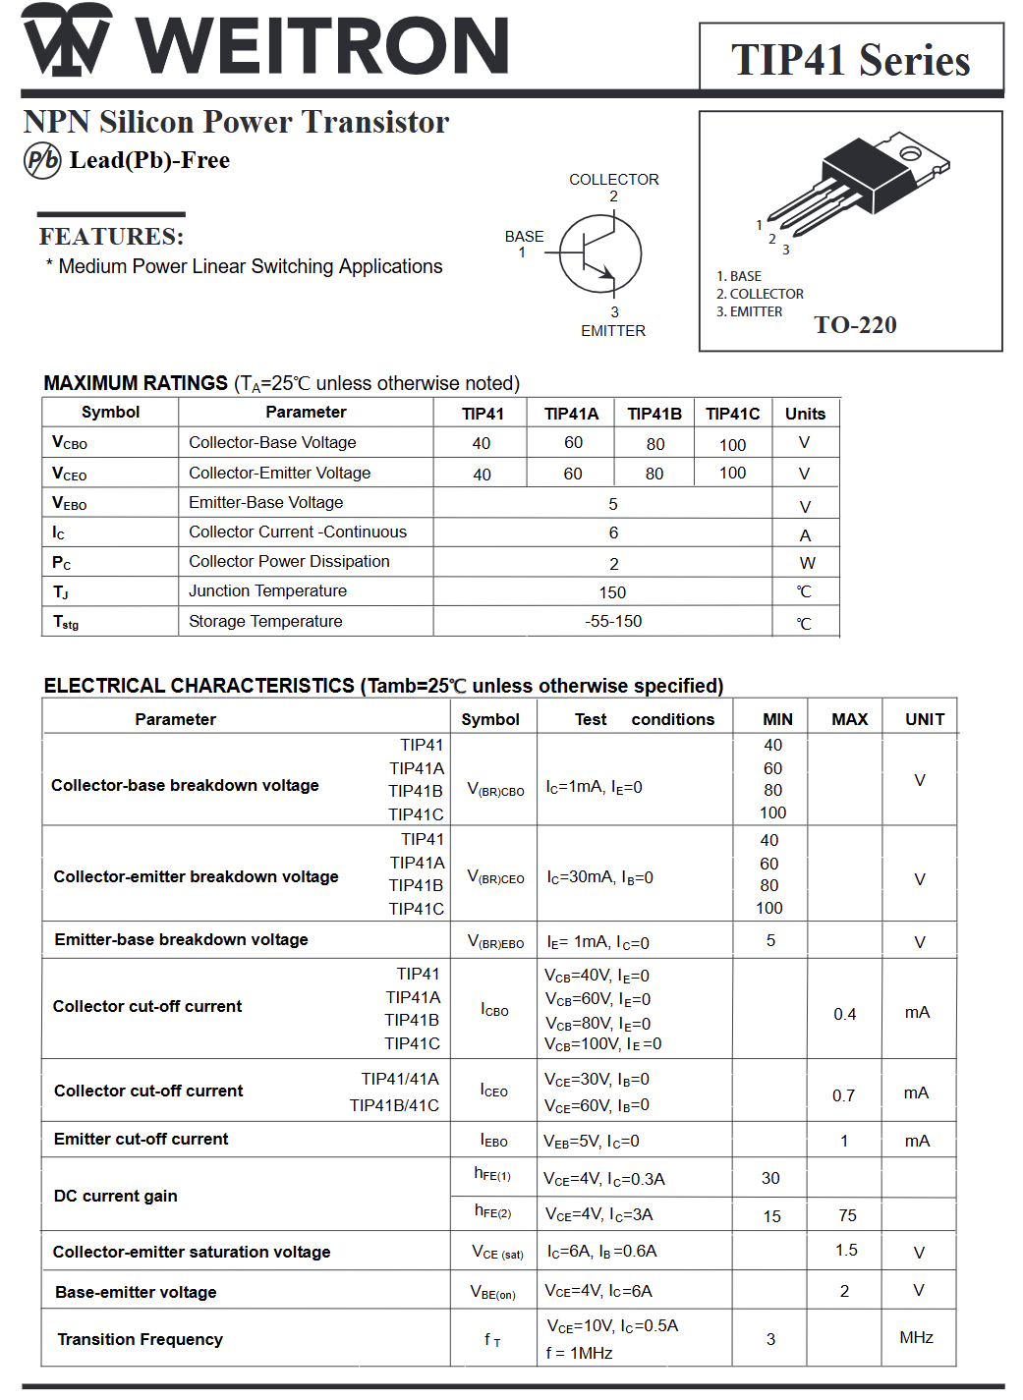
[picture p56: page 72]
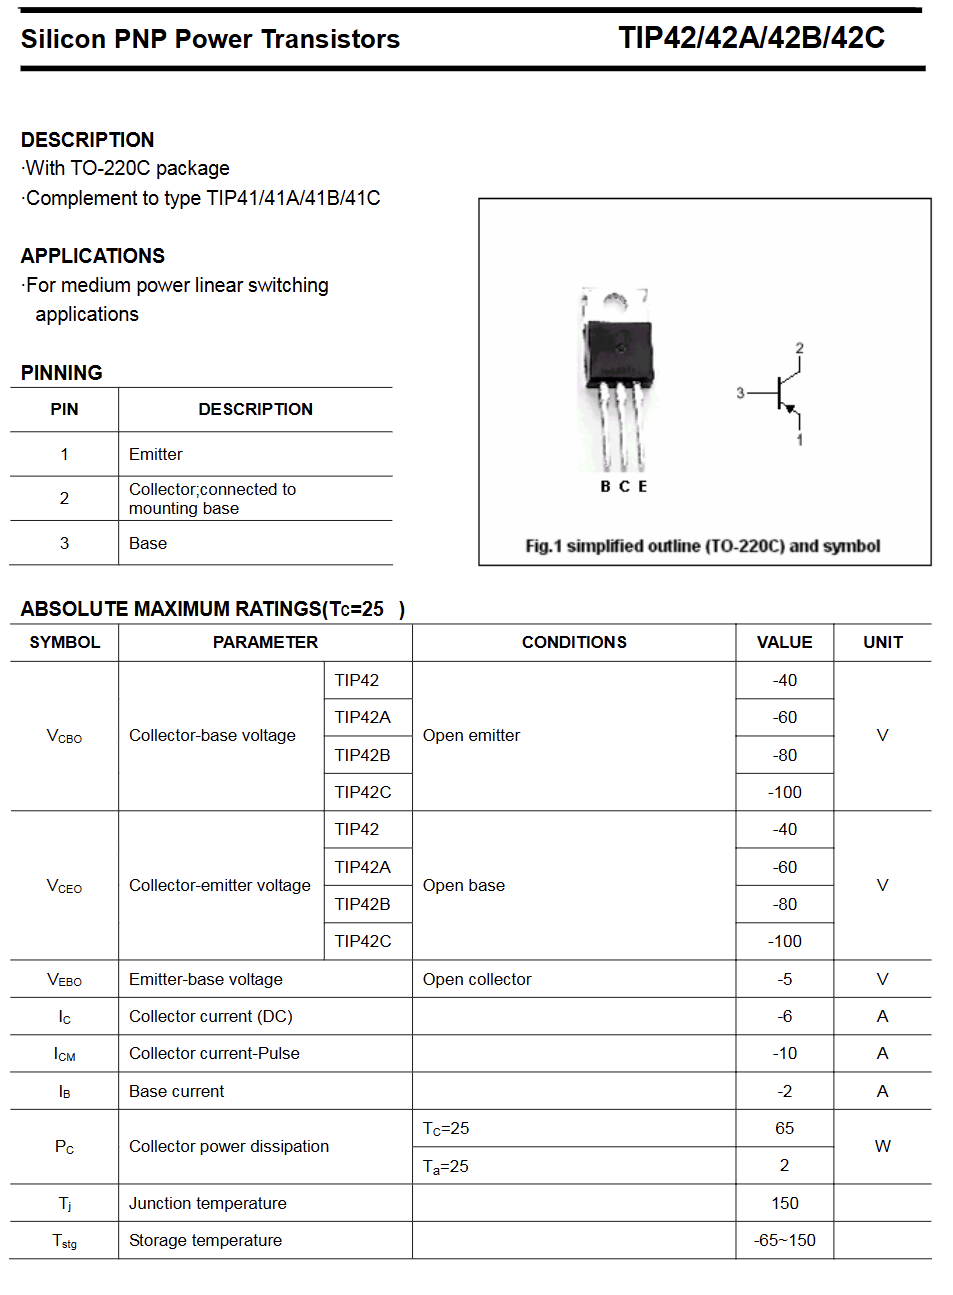
[picture p57: page 73]

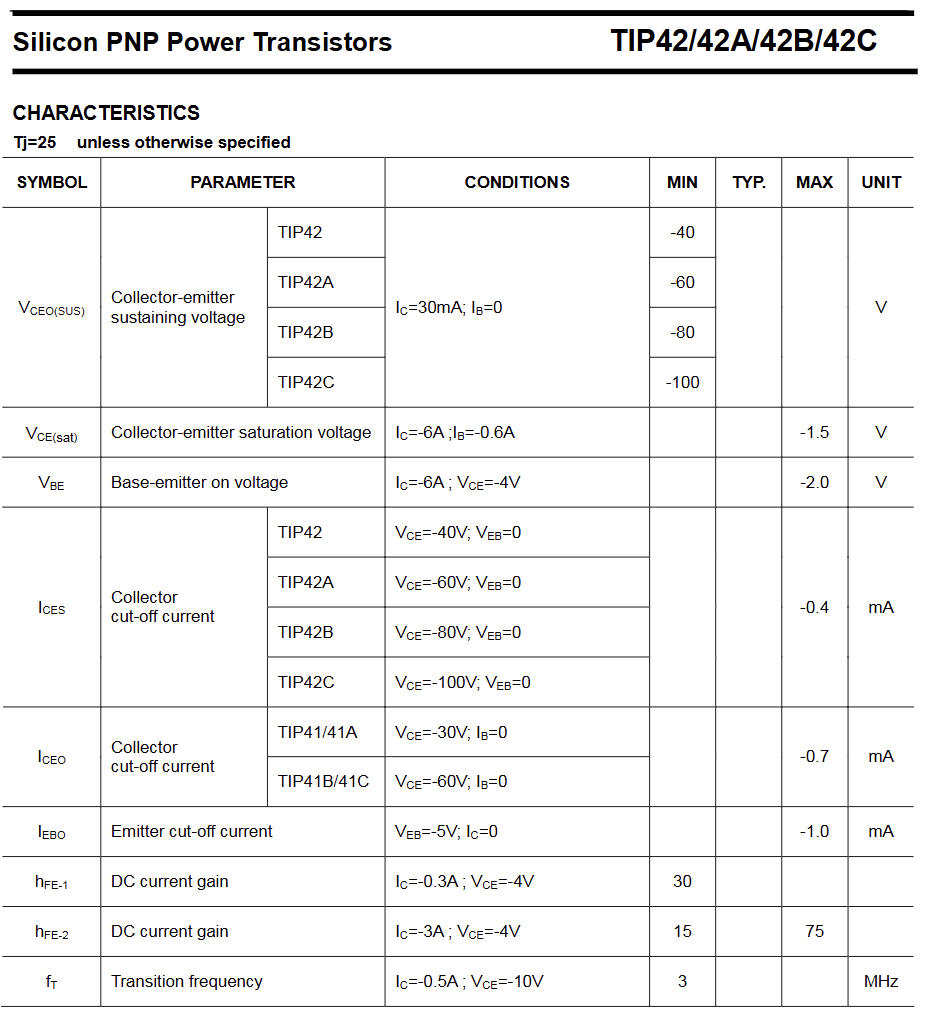
[picture p58: figure]
