lenghia902/15W_audio_power_amplifier/images/finished_board_bottom.png

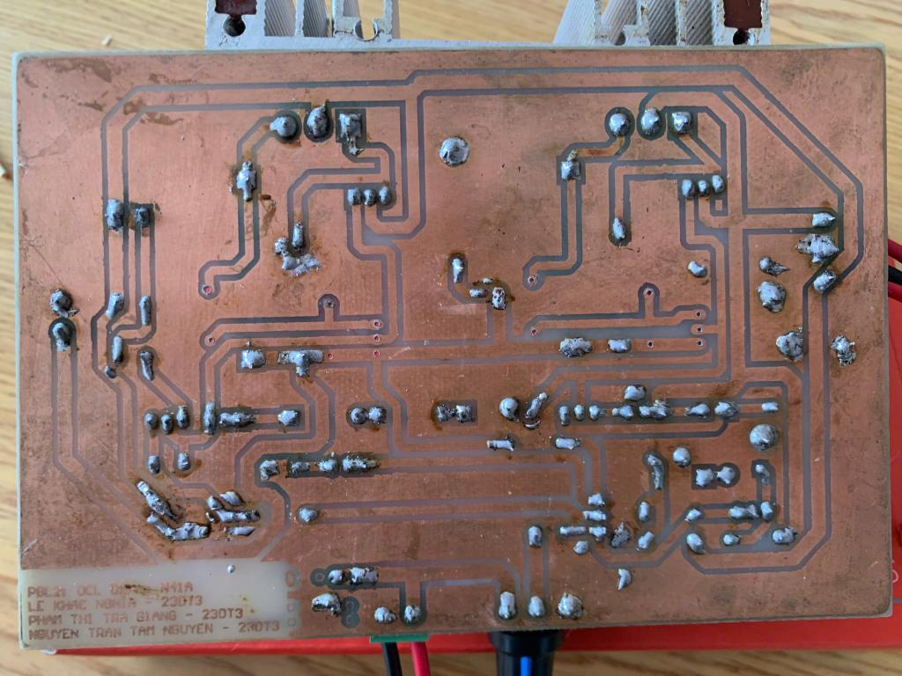
images/finished_board_bottom.png
