lenghia902/15W_audio_power_amplifier/(list of files, drawings)

Other design files:
hardware/pcb/OCL_15W.PcbDoc
hardware/schematic/OCL_15W.SchDoc
simulation/OCL_15W_simulation.pdsprj
